R3pRapst3r/Trinity/CAD/Images/dragonUHF_toolhead_Front.png

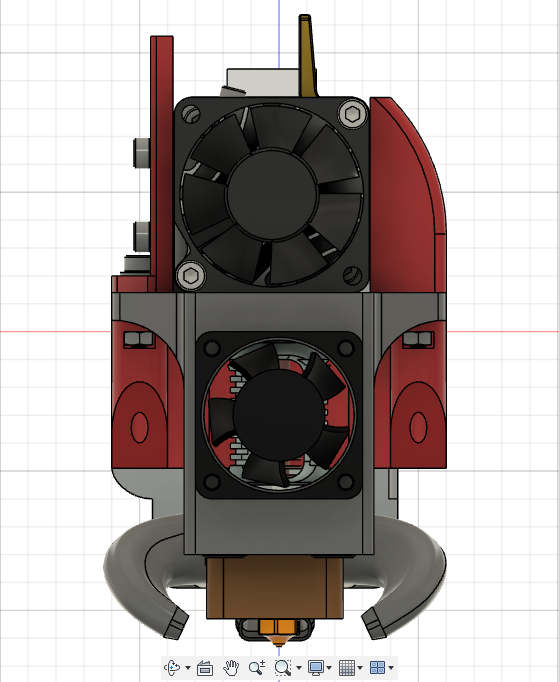
CAD/Images/dragonUHF_toolhead_Front.png
