R3pRapst3r/Trinity/CAD/Images/Front.png

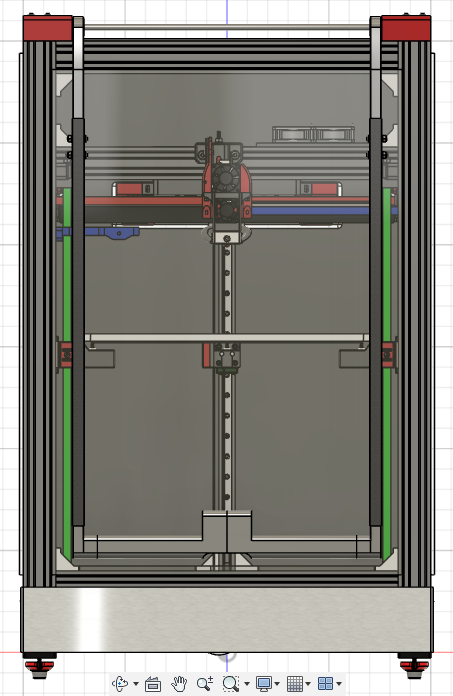
CAD/Images/Front.png
