R3pRapst3r/Trinity/CAD/Images/Rear.png

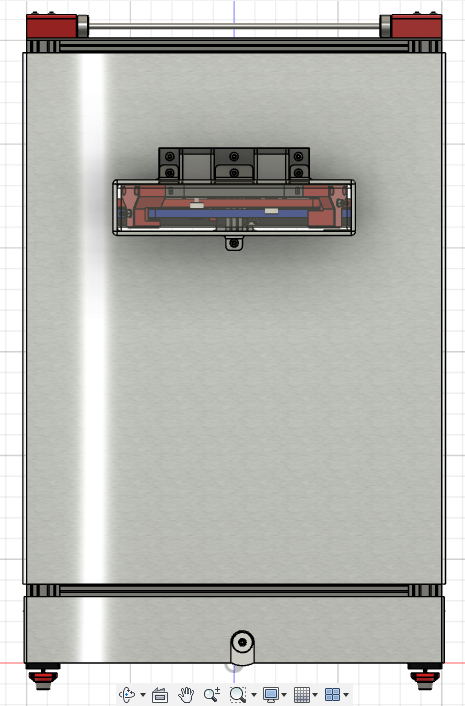
CAD/Images/Rear.png
