R3pRapst3r/Trinity/CAD/Images/Side.png

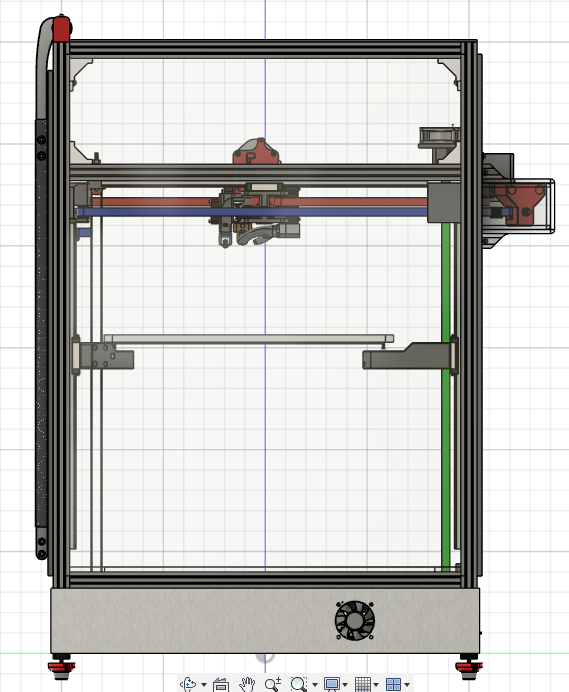
CAD/Images/Side.png
