R3pRapst3r/Trinity/Software/PrusaSlicer/customcode.png

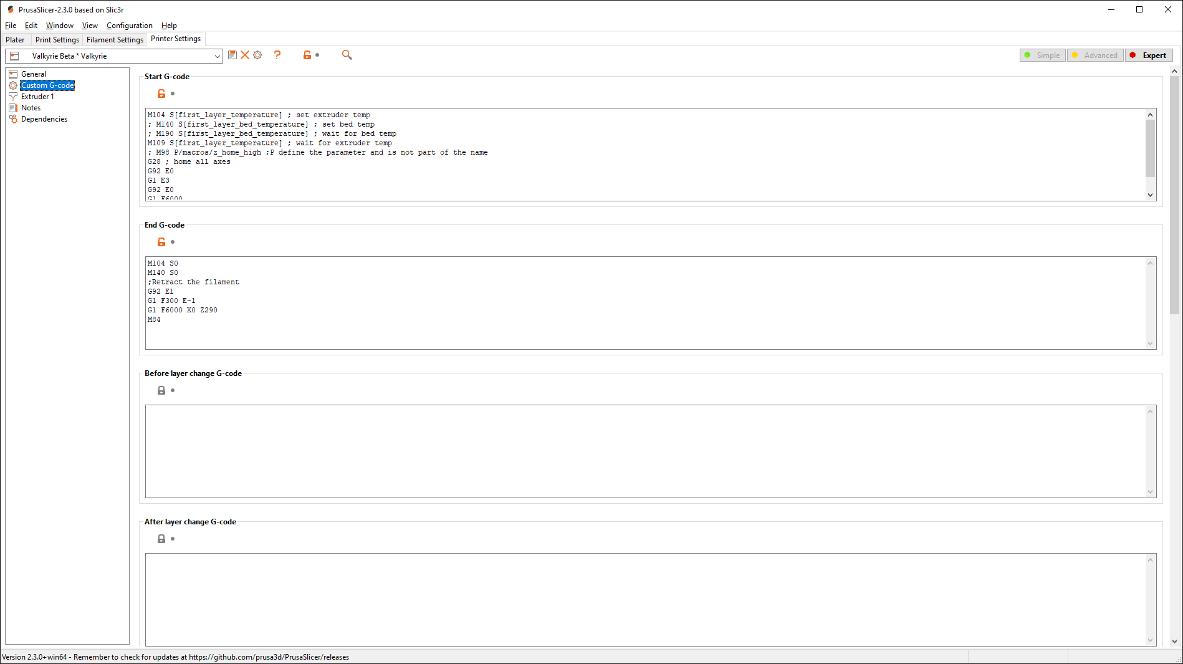
Software/PrusaSlicer/customcode.png
