R3pRapst3r/Trinity/Software/PrusaSlicer/extruder.png

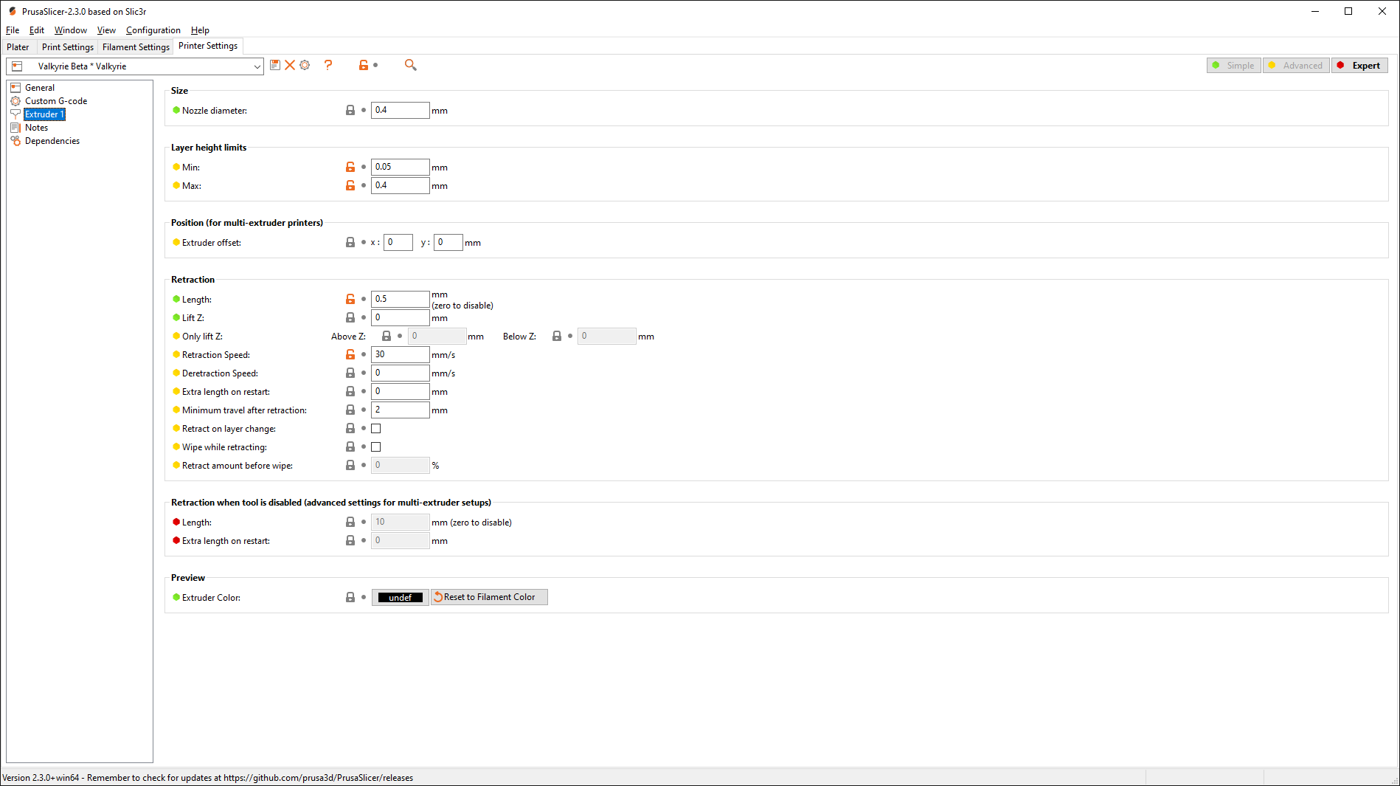
Software/PrusaSlicer/extruder.png
