R3pRapst3r/Trinity/Software/PrusaSlicer/general.png

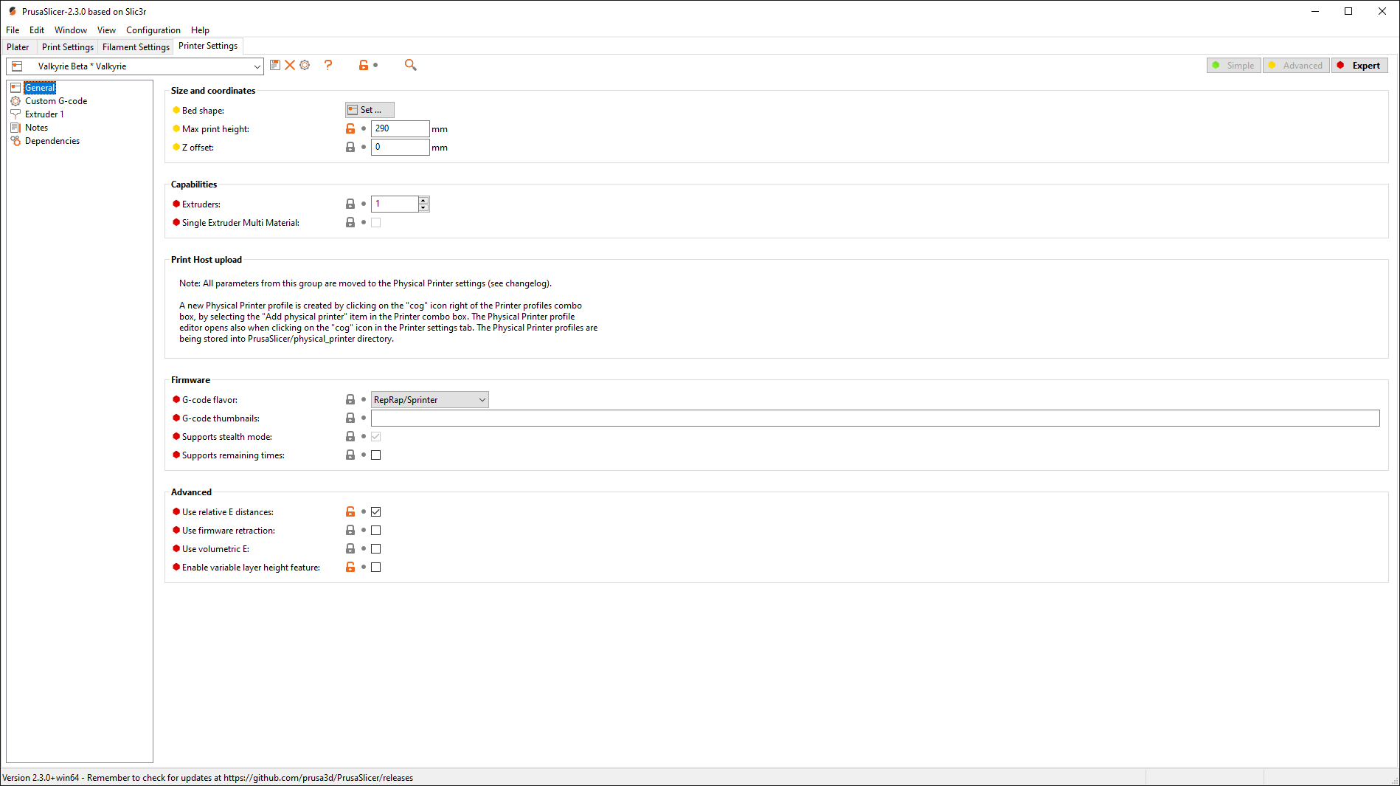
Software/PrusaSlicer/general.png
