R3pRapst3r/Trinity/BOM/BOM important notes.txt

BOM Note

IF ordering the CNA Hight temp full metal rails you MUST add a note in the order telling you want full metal carriages and medium preload!
