R3pRapst3r/Trinity/BOM/BOM v1.1.0.pdf

Valkyrie | 3d Printer Price exl VAT #REF!
System Category | Part Type Description Cut Length BOM Pack Price $ Pack Order Line Price $ mm Quantity Quantity | Order Parts Link Supplier
Frame Hardware Kinematic Motionparts Frame Hardware | T-Slot 2040 Z 2040 750 4 $ 14.70 4 $ 58.80 Linear Rails MGN 9h-Z Axis. NB! See note 400 1 $ 17.50 1 $ 17.50 Frame Bundle Frame Parts price exclusive Hardware #REF! | Color: 750 mm (https://s.click.aliexpress.com/e/_A2kG7t) 1xMGN9H/400mm Medium PL (https://s.click.aliexpress.com/e/_DdIajkF) | VenstPow CNA MS
Frame Hardware Frame Bundle Pick one of the kits below or order from above Frame Hardware Frame Bundle Misumi Frame & Rails & Hardware 1 $ 720.00 $ -Frame Hardware Frame Bundle V-Slot Frame & Rails & Hardware 1 $ 577.00 $ - | | Complete Premium Kit (https://makersupplies.dk/3d-print/3d-printers-kits/3d-printer-kits/valkyrie/3d-printers-kits-3d-printer-kits-valkyrie-frame-kit-misumi-t-slot) Complete V-Slot Kit (https://makersupplies.dk/3d-print/3d-printers-kits/3d-printer-kits/valkyrie/3d-printers-kits-3d-printer-kits-valkyrie-frame-kit-v-slot) | Partners MakerSupplies MakerSupplies
Frame | Hardware | T-Slot 2020 | Z 2020 Rear Center | 339 | 1 $ | 8.62 | 1 $ | 8.00 | Color: 339 mm (https://s.click.aliexpress.com/e/_9xANon) | VenstPow | Develompment Team Members
Frame | Hardware | T-Slot 2020 | X 2020 Rear Top | 420 | 1 $ | 9.50 | 1 $ | 9.50 | Color: 420 mm (https://s.click.aliexpress.com/e/_9xANon) | VenstPow | Mark Bridgewater - NZ
Frame | Hardware | T-Slot 2040 | X 2040 | 420 | 4 $ | 10.54 | 4 $ | 42.16 | Color: 420 mm (https://s.click.aliexpress.com/e/_A2kG7t) | VenstPow | Chris Lombardi - US
Frame | Hardware | T-Slot 2040 | Y 2040 | 480 | 4 $ | 11.12 | 4 $ | 44.48 | Color: 480 mm (https://s.click.aliexpress.com/e/_A2kG7t) | VenstPow | Roy Berntsen - NO
Frame | Hardware | Bracket | 2028 L Bracket | | 40 $ | 5.00 | 4 $ | 20.00 | 4x Color: 10pcs 2028 (https://s.click.aliexpress.com/e/_AqN7dv) | VenstPow | Support Links:
Frame | Hardware | Bracket | Corner Plate 90deg | | 4 $ | 10.00 | 4 $ | 40.00 | 1x 5pcs 2020 5 holes (https://s.click.aliexpress.com/e/_DdJj4Ej) | VenstPow | Buy Me a Coffee (https://ko-fi.com/pro3d)
Kinematic | Motionparts | Linear Rails | MGN 12h-Z Axis. NB! See note | 350 | 3 $ | 18.50 | 3 $ | 55.50 | 3xMGN 12H/350mm Medium PL (https://s.click.aliexpress.com/e/_DdIajkF) | CNA MS | By Patreon (https://www.patreon.com/pro3d)
Kinematic | Motionparts | Linear Rails | MGN 12h-Y Axis. NB! See note | 400 | 2 $ | 19.50 | 2 $ | 39.00 | 2xMGN12H/400mm Medium PL (https://s.click.aliexpress.com/e/_DdIajkF) | CNA MS | By PayPal (https://www.paypal.com/donate/?hosted_button_id=LZ7RAQGSE4SS8)
Frame | Hardware | Tube | 20x20x18 Carbon X-Axis Tube | 410 | 1 $ | 20.00 | 1 $ | 20.00 | 1x 20X20X18MM 500MM (https://s.click.aliexpress.com/e/_AK9Uei) | YTWS
Frame | Hardware | Tube | 15x15x13 Carbon Tube | 230 | 4 $ | 17.50 | 2 $ | 35.00 | 2x15X15X13MM 500MM (https://id.aliexpress.com/item/4000720317784.html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) | YTWS
Bed | Hardware | Plate | Cast Aluminum 350x350x8mm | 350 | 1225 $ | 0.08 | 1225 $ | 104.00 | 1225 cm^2 (https://makersupplies.dk/en/aluminum-sheet/921-aluminum-sheet-8mm-cnc-milled-cast-aluminum-sheet-custom-cut.html) | MakerSupplies
Bed | Hardware | Print Surface | Removal Spring Steel PEI Sheet | 330 | 1 $ | 46.00 | 1 $ | 46.00 | 1x Size: (130C)330x330mm (https://s.click.aliexpress.com/e/_9QsTsb) | Energetic
Bed | Hardware | Rod | 5x50mm Rod For Ball Joint | | 6 $ | 3.00 | 2 $ | 6.00 | 2x Length: 50mm 4PC (https://s.click.aliexpress.com/e/_AM7dI0) | WanFang
Bed | Hardware | Ball Joint | Precision Ball 10mm M4 | | 3 $ | 3.00 | 1 $ | 3.00 | 1x Size: 10pc (https://s.click.aliexpress.com/e/_ArYZR8) | KingRoon
AC/DC | Electronics | Controller Board | Duet 3 6HC | | 1 $ | 145.00 | 1 $ | 145.00 | 1x Duet 3 6HC (https://s.click.aliexpress.com/e/_DFJ8Ee7) | Fysetc
AC/DC | Electronics | PSU | Power Supply Unit | | 1 $ | 23.00 | 1 $ | 23.00 | 24V10A 240W (https://s.click.aliexpress.com/e/_9v6vDi) | Vusum
AC/DC | Electronics | Switch | Power Switch | | 1 $ | 7.50 | 1 $ | 7.50 | 1x Power switch (https://s.click.aliexpress.com/e/_AX4lXw) | TriangleLab
AC/DC | Electronics | Heater | Keenovo 750W Silicone Heater | 300 | 1 $ | 78.39 | 1 $ | 78.39 | 1x Color: 220V/110V (https://s.click.aliexpress.com/e/_AoRWc1) | Keenovo
AC/DC | Electronics | Switch | Solid State Relay | | 2 $ | 26.00 | 2 $ | 52.00 | Omron Solid State Relay (https://s.click.aliexpress.com/e/_DCq8m63) | Mellow
AC/DC | Electronics | Fuse | Thermal Fuse for AC Heater | | 1 $ | 3.00 | 1 $ | 3.00 | 1x Temperature: 150/180 degree (https://s.click.aliexpress.com/e/_AnVtSN) | Weidly
ToolHead | Electronics | Accelerometer | LIS3DSH Accelerometer | | 1 $ | 2.00 | 1 $ | 2.00 | 1x LIS3DSH Accelerometer (https://s.click.aliexpress.com/e/_APFI3d) | RQG
ToolHead | Extruder | Hotend | NF-Smart_Dg V2.0 | | 1 $ | 40.00 | 1 $ | 40.00 | 1x Color: Set 2/3/5/6 (https://s.click.aliexpress.com/e/_DlQsLtz) | Mellow
ToolHead | Extruder | Thermistor | PT1000 Thermistor Up to 450C | | 1 $ | 13.50 | 1 $ | 13.50 | 1x PT1000 Thermistor Cartridge (https://s.click.aliexpress.com/e/_9JVfyZ) | TriangleLab
ToolHead | Extruder | Extruder | BQ H2 V2S Lite | | 1 $ | 65.00 | 1 $ | 65.00 | H2 V2S LITE w/nema14 (https://s.click.aliexpress.com/e/_DFuG1tl) | BTT
ToolHead | Extruder | Tube | PTFE Teflon Tube | | 1 $ | 3.75 | 1 $ | 3.75 | 1x Size: 1M ID 2MM OD 3MM (https://s.click.aliexpress.com/e/_DnmpysP) | Mellow
ToolHead | Extruder | Tube | PTFE Teflon Tube | | 2 $ | 10.00 | 1 $ | 10.00 | 1x Size: 2M ID 4MM OD 6MM (https://s.click.aliexpress.com/e/_DnmpysP) | Mellow
Kinematic | Hardware | Rod | 5x25mm Rod For Tension Forks | | 5 $ | 1.20 | 1 $ | 1.20 | 1x Length: 25mm 8PC (https://s.click.aliexpress.com/e/_AM7dI0) | WanFang
Kinematic | Hardware | Rod | 5x40mm Rod For AB Idlers | | 12 $ | 3.00 | 3 $ | 9.00 | 3x Length: 40mm 5PC (https://s.click.aliexpress.com/e/_AM7dI0) | WanFang
Kinematic | Motionparts | Belt | Timing Belt 2GT 9mm 135C | | 8 $ | 59.00 | 1 $ | 59.00 | 1x 8M Heat Resistant - 9mm (https://s.click.aliexpress.com/e/_ABtzv6) | TriangleLab
Kinematic | Motionparts | Idler | Idlers Smooth 11mm | | 10 $ | 4.10 | 10 $ | 41.00 | 10x W 11mm without t (https://s.click.aliexpress.com/e/_9gG5gi) | Mellow
Kinematic | Motionparts | Idler | Idlers Toothed 11mm | | 5 $ | 6.00 | 5 $ | 30.00 | 5x W 11mm with t (https://s.click.aliexpress.com/e/_9gG5gi) | Mellow
Kinematic | Motionparts | Pulley | Pulley 11mm 2GT | | 5 $ | 4.00 | 5 $ | 20.00 | 5x For 9mm (https://s.click.aliexpress.com/e/_A6Q066) | Mellow
Kinematic | Motionparts | Gear | 2GT 20T-80T 4:1 Belt Gear | 200 | 3 $ | 16.00 | 3 $ | 48.00 | 3x 20T(5mm)-80T(5mm)-200mm (https://s.click.aliexpress.com/e/_9xvamN) | Powge
Kinematic | Motionparts | Steppermotor | 42mm NEMA 17 1.7A | | 5 $ | 14.50 | 5 $ | 72.50 | 1x 5Pcs 40mm 45N-cm 2A (https://s.click.aliexpress.com/e/_ALKIWP) | StepperOnline
Enclosure | Insulation | Insulation | PIR - Polyisocyanurate | | 5 $ | 12.00 | 5 $ | 60.00 | TBD (https://www.kingspan.com/gb/en-gb/products/insulation-boards/insulation-boards/therma) | Source Locally
Enclosure | Panel | Panels | Aluminum Composite Material | | 5 $ | 25.00 | 5 $ | 125.00 | TBD (https://www.curbellplastics.com/Research-Solutions/Materials/Aluminum-Composite-Material-(ACM)) | Source Locally
Enclosure | Panel | Window Front | Polycarbonate Sheet | 300 | 2 $ | 25.00 | 2 $ | 50.00 | Specification: 350x350x3mm (https://s.click.aliexpress.com/e/_ADhhGV) | BEAO
Enclosure | Electronics | Cable | High Temperature PTFE Cable | | 5 $ | 3.23 | 5 $ | 16.15 | 5x Length: 5 Meters (https://s.click.aliexpress.com/e/_DD5IYAj) | Antfox Store
Drybox | Electronics | Sensor | 5KG Load Cell and HX711 ADC | | 1 $ | 3.00 | 1 $ | 3.00 | Color: 5KG With HX711 (https://s.click.aliexpress.com/e/_9gb4OH) | Estardyn
Enclosure | Electronics | Fan | 60mm Sunon MF60202V3 | | 2 $ | 12.00 | 2 $ | 24.00 | 1x Sunon MF60202V3 (https://s.click.aliexpress.com/e/_Dlpy6BN) | SENSDA
Drybox | Electronics | Heater | PTC Heater 12x7cm 260C | | 1 $ | 12.00 | 1 $ | 12.00 | PTC Heater with Cord (US or EU) (https://www.aliexpress.com/item/1005003758412972.html) | YEKMLCO
Drybox | Electronics | Fuse | Thermal Fuse 95C | | 1 $ | 3.96 | 1 $ | 3.96 | 1x 15A - 95C (https://www.aliexpress.com/item/32885492280.html) | TS
Drybox | electronics | PCB assy | HX711 + 5kg Load cell | | 1 $ | 3.72 | 1 $ | 3.72 | 1x5kg loadcell + HX711 (https://s.click.aliexpress.com/e/_DlWkD9l) | EQV Store
Drybox | electronics | Controller Board | ESP32 WiFi Board | | 1 $ | 4.00 | 1 $ | 4.00 | 1xESP-32 30Pin (https://www.aliexpress.com/item/4000071762309.html) | EQV Store
Drybox | electronics | Controller Board | ESP32 DEV BOARD | | 1 $ | 3.00 | 1 $ | 3.00 | 1xESP32-V1 SHIELD 30P (https://www.aliexpress.com/item/4000071762309.html) | EQV Store
Drybox | electronics | Sensor | DHT22 Humididty + Temp Sensor | | 1 $ | 3.00 | 1 $ | 3.00 | 1xDHT22 Sensor (https://s.click.aliexpress.com/e/_DmMW6hH) | YX EC
Drybox | Drying Agent | Desiccant | Calsium Chloride | | 1 $ | 15.00 | 1 $ | 15.00 | Source Locally | Locally
Fasteners | Various See Fastener sheet 1 $226
Valkyrie | Bundle Price Price exl VAT #REF!

## valkyrie

## stage - I

## BOM
