R3pRapst3r/Trinity/BOM/Fasteners-BOM v1.1.0.pdf

Hardware Price exl VAT $ 226
Quantity Pack Price $ Pack Order BOM Line Price Part Type Description Quantity $ | Order Parts Link Supplier DIN ISO
Bushing | 5x8x2.5M Bushings | 2 $ | 4.31 | 1 $ | 4.31 | 1x 10pcs Bushings 5x8x2.5 (https://s.click.aliexpress.com/e/_9Gy22J) | GEPS | | | Develompment Team Members
Nut | M3 Nut | 44 $ | 1.00 | 1 $ | 1.00 | 1x Size: M3 50PCS (https://s.click.aliexpress.com/e/_AB2MMx) | WanFang | 934 | 4032 | Mark Bridgewater - NZ
Nut | M3 Nut Hammer Nut | 68 $ | 3.00 | 2 $ | 6.00 | 1x 50PCS Size: 20-m3 (https://s.click.aliexpress.com/e/_A3vamf) | WanFang | | | Chris Lombardi - US
Nut | M3 Nut Locknut | 6 $ | 0.49 | 1 $ | 0.49 | 1x Size: M3 50PCS - SS (https://s.click.aliexpress.com/e/_AKYhBV) | WanFang | | 10511 | Roy Berntsen - NO
Washer | M3 WASHER | 31 $ | 0.74 | 1 $ | 0.74 | 1x: M3 50pcs (https://id.aliexpress.com/item/1005003078979017.html) | WanFang | 125
M3-50 | M3x03 Set/Grub Screw | 8 $ | 0.56 | 1 $ | 0.56 | 1 x 50PCs M3 x 3 (https://s.click.aliexpress.com/e/_DmWF6r5) | WanFang | 916 | | Support Links:
Screw | M3x08 BH | 36 $ | 1.00 | 1 $ | 1.00 | 1x Size: M3 50PCS - 8mm - 304 SS (https://s.click.aliexpress.com/e/_A3cUtH) | WanFang | | 7380 | Buy Me a Coffee (https://ko-fi.com/pro3d)
Screw | M3x08 FH CS | 11 $ | 1.12 | 1 $ | 1.12 | 1 x 50PCs M3 x 8mm SS (https://www.aliexpress.com/item/32939396668.html) | WanFang | 7991 | 10642 | By Patreon (https://www.patreon.com/pro3d)
Screw | M3x08 SH | 38 $ | 1.00 | 1 $ | 1.00 | 1x Size: M3 50PCS - 8mm - 304 SS (https://s.click.aliexpress.com/e/_9JOB4f) | WanFang | 912 | | By PayPal (https://www.paypal.com/donate/?hosted_button_id=LZ7RAQGSE4SS8)
Screw | M3x10 BH | 31 $ | 1.00 | 1 $ | 1.00 | 1x Size: M3 50PCS - 10mm - 304 SS (https://s.click.aliexpress.com/e/_A2YDOx) | WanFang | | 7380
Screw | M3x10 SH | 29 $ | 1.07 | 1 $ | 1.07 | 1 x 50PCs M3 x 10mm SS (https://s.click.aliexpress.com/e/_Dmmm4hv) | WanFang | 912 | 4762
Screw | M3x16 BH | 11 $ | 2.00 | 1 $ | 2.00 | 1x Size: M3 50PCS - 16mm - 304 SS (https://s.click.aliexpress.com/e/_A2YDOx) | WanFang | | 7380
Screw | M3x25 SH | 4 $ | 1.50 | 1 $ | 1.50 | 1 x 50 Pcs M3 x 25 SS (https://s.click.aliexpress.com/e/_DkbO2A7) | WanFang | 912
Spacer | M3x30 FF Standoff | 4 $ | 3.27 | 1 $ | 3.27 | 1x Size: M3 - 30mm (https://s.click.aliexpress.com/e/_AfiKZd) | WanFang
Spacer | M3x30 FM Standoff | 4 $ | 2.57 | 1 $ | 2.57 | 1x Size: 5PCS M3XL M-F (https://s.click.aliexpress.com/e/_9yFDij) | WanFang
Screw | M4 D5 L55 Shoulder Screw | 3 $ | 4.00 | 3 $ 12.00 | 3x Size: M4-D5mm x 55mm (https://s.click.aliexpress.com/e/_9x0mWr) | YFS

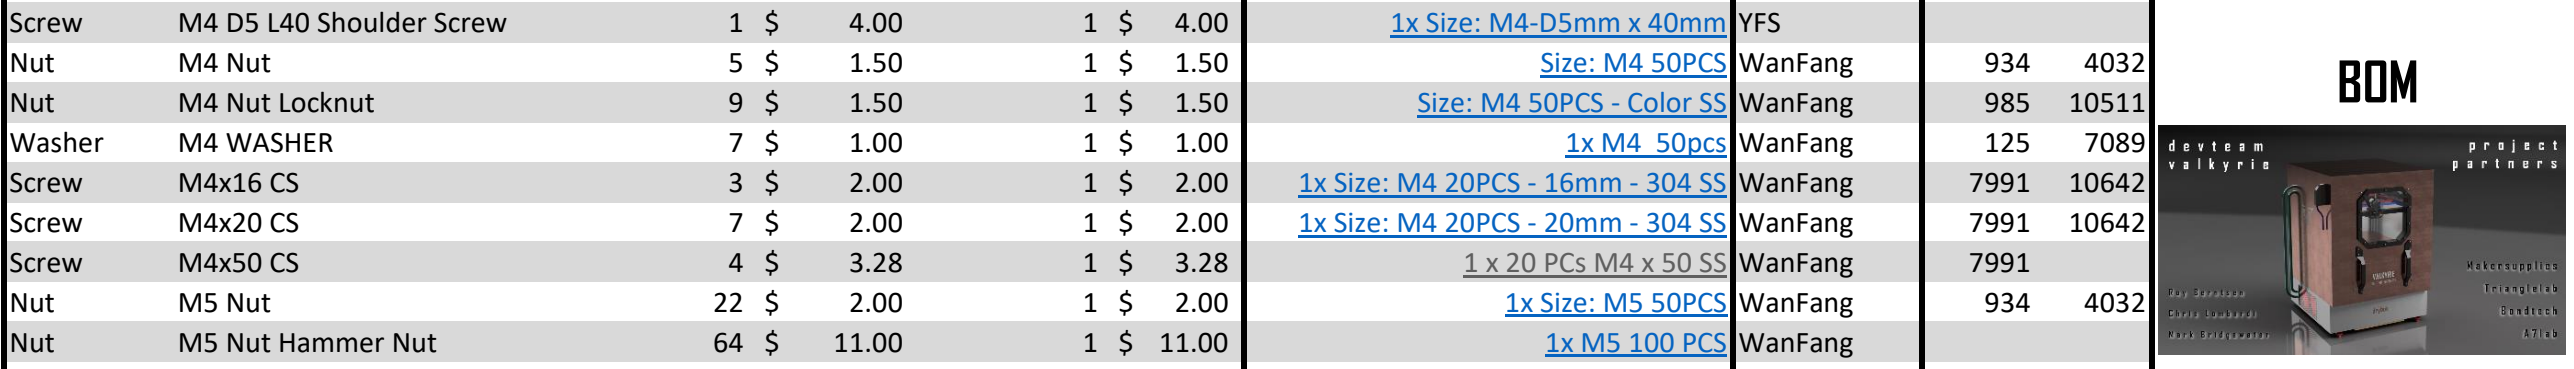
[picture p10: figure]
Screw; M4 D5 L40 Shoulder Screw; 1x Size: M4-D5mm x 40mm; YFS; Nut; M4 Nut; Size: M4 50PCS; WanFang; Washer; M4 WASHER; 1x M4 50pcs; M5 Nut; 1x Size: M5 50PCS; M5 Nut Hammer Nut; 1x M5 100 PCS; BOM

Nut | M4 Nut Locknut | 9 $ | 1.50 | 1 $ | 1.50 | Size: M4 50PCS - Color SS (https://s.click.aliexpress.com/e/_AkJ18P) | WanFang | 985 | 10511
Screw | M4x16 CS | 3 $ | 2.00 | 1 $ | 2.00 | 1x Size: M4 20PCS - 16mm - 304 SS (https://s.click.aliexpress.com/e/_9RUjsB) | WanFang | 7991 | 10642
Screw | M4x20 CS | 7 $ | 2.00 | 1 $ | 2.00 | 1x Size: M4 20PCS - 20mm - 304 SS (https://s.click.aliexpress.com/e/_ASPnXl) | WanFang | 7991 | 10642
Screw | M4x50 CS | 4 $ | 3.28 | 1 $ | 3.28 | 1 x 20 PCs M4 x 50 SS (https://s.click.aliexpress.com/e/_DCNVYyb) | WanFang | 7991
Nut | M5 Nut Locknut | 15 $ | 2.81 | 1 $ | 2.81 | 1x M5 50 PCS - SS (https://s.click.aliexpress.com/e/_ACjUAP) | WanFang | 985 | 10511
Nut | M5 Nut T-Nut | 72 $ | 13.50 | 1 $ 13.50 | 1x M5 100PCS (https://s.click.aliexpress.com/e/_9iXP6T) | WanFang
Collar | M5 Retaining Collar | 1 $ | 3.62 | 1 $ | 3.62 | GDZS-D5-10-6 (https://s.click.aliexpress.com/e/_Aoo551) | Micky
Washer | M5 WASHER | 141 $ | 1.28 | 2 $ | 2.56 | 2x M5 50PCS (https://s.click.aliexpress.com/e/_9vb6PD) | WanFang | 125 | 7089
Screw | M5x10 BH | 141 $ | 2.69 | 15 $ 40.35 | 12x 10PCS Size: M5 - 10mm - SS (https://s.click.aliexpress.com/e/_AkraqJ) | WanFang | 7380
Screw | M5x20 BH | 9 $ | 8.00 | 1 $ | 8.00 | 1x 10PCS Size: M5 - 20mm - SS (https://s.click.aliexpress.com/e/_9zqQrh) | WanFang | | 7380
Screw | M5x30 BH | 4 $ | 1.64 | 1 $ | 1.64 | 1 x 5PCS M5 x 30 ss (https://s.click.aliexpress.com/e/_DesnUZp) | YFS | | 7380
Bolt | M5x30 HEX | 5 $ | 2.57 | 1 $ | 2.57 | 1x 10 PCS Size: M5 - 30mm (https://s.click.aliexpress.com/e/_980mef) | WanFang | 933
Bolt | M5x50 HEX DIN 933 | 15 $ | 3.04 | 2 $ | 6.08 | 1 x 10 PCs M5 x 50 (https://www.aliexpress.com/item/1005003034350931.html) | WanFang | 933
Shim | M5x6.5x1 Precision Shim | 33 $ | 16.00 | 1 $ 16.00 | 1x 200PCS Size: 6.5x5x1mm (https://s.click.aliexpress.com/e/_DFr9KHh) | BulkMan
Rod | M8x380 Steel Rod - Door Link | 1 $ | 9.50 | 1 $ | 9.50 | 1 x 8mm dia x 400mm SS (https://s.click.aliexpress.com/e/_Dmf08Nh) | YUNSHUO
Magnet | Round Magnets With Hole | 3 $ | 4.50 | 1 $ | 4.50 | 1x Color: 8x3-3mm-20pcs (https://s.click.aliexpress.com/e/_9H0d0B) | HongKai
Magnet | Ø20 10Kg Magnet + washer | 6 $ | 9.20 5 +1 | $ | 9.20 | 5 + 1 D20 magnet and keeper (https://s.click.aliexpress.com/e/_DloVAMP) | LFYGY Ind (https://www.aliexpress.com/store/912301249)
Bearings | 625 2ZZ | 6 $ | 7.50 | 1 $ | 7.50 | 10pcs 625ZZ 5x16x5mm (https://s.click.aliexpress.com/e/_AZ42Hh) | VenstPow
Bearings | Draw Slides | 2 $ | 24.00 | 1 $ 24.00 | Color: Buffer 16inch 40cm (https://s.click.aliexpress.com/e/_9gB9LL) | Naierdi
Bearings | 608 Bearings | 3 $ | 5.01 | 1 $ | 5.01 | 1x Size: ABEC-1 ZZ (https://s.click.aliexpress.com/e/_AbdgsT) | Kande
Spring | Tension Spring | 1 $ | 1.72 | 1 $ | 1.72 | 1x Length 15mm - Wire 0.7 - OD 8 (https://s.click.aliexpress.com/e/_AN8H8f) | Zhongfa
Fasteners Price exl VAT | $ | 226

# Project Valkyrie Fastener BOM

# valkyrie

# fasteners
