R3pRapst3r/Trinity/STLs/Printed parts list.xlsx

Sheet: Sheet1
Valkyrie | Frame Parts | Total time / weight |  |  | 111:10:00 | 3217 g
Price/kg | $40.00 | add your price
Price/g | $0.04 |  |  |  |  | $128.68
System | Part | Time | Weight | Quantity | Time Tot | Weight Tot | Support
AB | A Idler Bracket Front_1x | 0:37:00 | 22 g | 1 | 0:37:00 | 22 | No
AB | A Idler Bracket Rear_1x | 1:03:00 | 40 g | 1 | 1:03:00 | 40 | No
AB | A Idler Tension Tower_1x | 1:09:00 | 39 g | 1 | 1:09:00 | 39 | No
AB | A Y-Carrier A1_1x | 0:28:00 | 14 g | 1 | 0:28:00 | 14 | No
AB | A Y-Carrier A2_1x | 0:53:00 | 28 g | 1 | 0:53:00 | 28 | No
AB | AB Motor Bracket_1x | 4:46:00 | 185 g | 1 | 4:46:00 | 185 | No
AB | AB Toolhead Carrier_1x | 0:00:00 | 31 g | 1 | 0:00:00 | 31 | BPO
AB | AB Toolhead Fan Chimney_1x | 0:33:00 | 14 g | 1 | 0:33:00 | 14 | No
AB | AB Toolhead Fan Duct_1x | 0:20:00 | 14 g | 1 | 0:20:00 | 14 | No
AB | AB Toolhead Top Plate_1x | 0:42:00 | 10 g | 1 | 0:42:00 | 10 | No
AB | B Idler Bracket Front_1x | 0:35:00 | 22 g | 1 | 0:35:00 | 22 | No
AB | B Idler Bracket Rear_1x | 1:03:00 | 40 g | 1 | 1:03:00 | 40 | No
AB | B Idler Tension Tower_1x | 1:13:00 | 40 g | 1 | 1:13:00 | 40 | No
AB | B Y-Carrier B1_1x | 0:28:00 | 14 g | 1 | 0:28:00 | 14 | No
AB | B Y-Carrier B2_1x | 0:52:00 | 28 g | 1 | 0:52:00 | 28 | No
Z | Z AB-Belt Lock_2x | 0:13:00 | 6 g | 2 | 0:26:00 | 12 | No
Z | Z ABC Tension Fork_3x | 0:08:00 | 4 g | 3 | 0:24:00 | 12 | No
Z | Z AB-Coverbuddy_2x | 0:11:00 | 8 g | 2 | 0:22:00 | 16 | No
Z | Z A-Carrier_1x | 1:40:00 | 61 g | 1 | 1:40:00 | 61 | No
Z | Z A-Gear Bracket_1x | 1:23:00 | 56 g | 1 | 1:23:00 | 56 | No
Z | Z A-Gear Cover_1x | 1:48:00 | 68 g | 1 | 1:48:00 | 68 | No
Z | Z B-Carrier_1x | 1:40:00 | 61 g | 1 | 1:40:00 | 61 | No
Z | Z B-Gear Bracket_1x | 1:22:00 | 56 g | 1 | 1:22:00 | 56 | No
Z | Z B-Gear Cover_1x | 1:47:00 | 68 g | 1 | 1:47:00 | 68 | No
Z | Z C-Belt Lock_1x | 0:14:00 | 6 g | 1 | 0:14:00 | 6 | No
Z | Z C-Carrier_1x | 1:54:00 | 71 g | 1 | 1:54:00 | 71 | No
Z | Z C-Gear Bracket_1x | 1:33:00 | 63 g | 1 | 1:33:00 | 63 | No
Z | Z C-Coverbuddy_1x | 0:08:00 | 6 g | 1 | 0:08:00 | 6 | No
Z | Z C-Gear Cover_1x | 1:52:00 | 68 g | 1 | 1:52:00 | 68 | No
Z | Z Idler Bracket AB_2x | 0:42:00 | 24 g | 2 | 1:24:00 | 48 | No
Z | Z Idler Bracket C_1x | 0:58:00 | 34 g | 1 | 0:58:00 | 34 | No
Chamber | Door Handle A_1x | 1:08:00 | 46 g | 1 | 1:08:00 | 46 | No
Chamber | Door Handle B_1x | 1:08:00 | 46 g | 1 | 1:08:00 | 46 | No
Chamber | Door Magnet Buddy Lower AB_2x | 0:17:00 | 10 g | 2 | 0:34:00 | 20 | No
Chamber | Door Window Frame Inner_2x | 2:53:00 | 123 g | 2 | 5:46:00 | 246 | No
Chamber | Door Window Frame Outer_1x | 2:30:00 | 107 g | 1 | 2:30:00 | 107 | No
Chamber | Doorlift Door Bracket A_1x | 2:00:00 | 80 g | 1 | 2:00:00 | 80 | No
Chamber | Doorlift Door Bracket B_1x | 2:00:00 | 80 g | 1 | 2:00:00 | 80 | No
Chamber | Doorlift Lower Arm Bracket AB_2x | 0:16:00 | 9 g | 2 | 0:32:00 | 18 | No
Chamber | Doorlift Upper Arm Bracket A_1x | 0:45:00 | 27 g | 1 | 0:45:00 | 27 | No
Chamber | Doorlift Upper Arm Bracket B_1x | 0:45:00 | 27 g | 1 | 0:45:00 | 27 | No
Chamber | LUA - Lower Elbow_4x | 0:19:00 | 11 g | 4 | 1:16:00 | 44 | BPO
Chamber | LA-AB Upper Elbow_2x | 0:22:00 | 12 g | 2 | 0:44:00 | 24 | BPO
Chamber | Rear AB Motor Cover_1x | 10:00:00 | 400 g | 1 | 10:00:00 | 400 | No
Chamber | UA-A Upper Elbow_1x | 0:33:00 | 19 g | 1 | 0:33:00 | 19 | BPO
Chamber | UA-B Upper Elbow_1x | 0:33:00 | 19 g | 1 | 0:33:00 | 19 | BPO
Drybox | dbx drawslide buddy spacer_4x | 0:09:00 | 5 g | 4 | 0:36:00 | 20 | No
Drybox | dbx drawslide buddy_4x | 0:09:00 | 5 g | 4 | 0:36:00 | 20 | No
Drybox | dbx fanduct stand_2x | 0:22:00 | 12 g | 2 | 0:44:00 | 24 | No
Drybox | dbx fanduct_1x | 4:00:00 | 175 g | 1 | 4:00:00 | 175 | No
Drybox | dbx silica container lid_2x | 0:20:00 | 14 g | 2 | 0:40:00 | 28 | No
Drybox | dbx silica container_2x | 4:45:00 | 111 g | 2 | 9:30:00 | 222 | No
Drybox | Carousel Bearing Pin_3x | 0:04:00 | 2 g | 3 | 0:12:00 | 6 | No
Drybox | Carousel Bottom Bearing Plate_1x | 2:03:00 | 84 g | 1 | 2:03:00 | 84 | No
Drybox | Carousel Inner Lower Ring_1x | 0:48:00 | 33 g | 1 | 0:48:00 | 33 | No
Drybox | Carousel Inner Upper Ring_1x | 0:40:00 | 26 g | 1 | 0:40:00 | 26 | No
Drybox | Carousel Loadcell Spacer_1x | 0:08:00 | 3 g | 1 | 0:08:00 | 3 | No
Drybox | Carousel Outer Ring_1x | 2:35:00 | 104 g | 1 | 2:35:00 | 104 | No
Drybox | Carousel Spool Jaw_3x | 0:05:00 | 2 g | 3 | 0:15:00 | 6 | No
Drybox | Carousel Spring Cup_1x | 0:02:00 | 1 g | 1 | 0:02:00 | 1 | No
Drybox | Carousel Tightner Tool_1x | 0:30:00 | 15 g | 1 | 0:30:00 | 15 | No
Frame Parts | Total time / weight |  |  |  | 111:10:00 | 3217 g
Estimated filament price
Price/kg | $40.00
Price/g | $0.04 |  |  |  |  | $128.68

Sheet: Sheet2
System | Part | Time | Weight | Quantity | Time Tot | Weight Tot | Support
Chamber | Door Handle A_1x | 1:08:00 |  | 1 | 1:08:00 |  | No
Chamber | Door Handle B_1x | 1:08:00 |  | 1 | 1:08:00 |  | No
Chamber | Door Magnet Buddy Lower AB_2x | 0:17:00 |  | 2 | 0:34:00 |  | No
Chamber | Door Window Frame Inner_2x | 2:53:00 |  | 2 | 5:46:00 |  | No
Chamber | Door Window Frame Outer_1x | 2:30:00 |  | 1 | 2:30:00 |  | No
Chamber | Doorlift Lower Arm Bracket AB_2x | 0:16:00 |  | 2 | 0:32:00 |  | No
Chamber | Doorlift Upper Arm Bracket A_1x | 0:45:00 |  | 1 | 0:45:00 |  | No
Chamber | Doorlift Upper Arm Bracket B_1x | 0:45:00 |  | 1 | 0:45:00 |  | No
Chamber | LA-A Lower Elbow_1x | 0:19:00 |  | 1 | 0:19:00 |  | No
Chamber | LA-A Upper Elbow_1x | 0:22:00 |  | 1 | 0:22:00 |  | No
Chamber | LA-B Lower Elbow_1x | 0:19:00 |  | 1 | 0:19:00 |  | No
Chamber | LA-B Upper Elbow_1x | 0:22:00 |  | 1 | 0:22:00 |  | No
Chamber | Rear AB Motor Cover_1x | 10:00:00 |  | 1 | 10:00:00 |  | No
Chamber | UA-A Lower Elbow_1x | 0:19:00 |  | 1 | 0:19:00 |  | No
Chamber | UA-A Upper Elbow_1x | 0:33:00 |  | 1 | 0:33:00 |  | No
Chamber | UA-B Lower Elbow_1x | 0:19:00 |  | 1 | 0:19:00 |  | No
Chamber | UA-B Upper Elbow_1x | 0:33:00 |  | 1 | 0:33:00 |  | No
