R3pRapst3r/Trinity/CAD/355mm_build_plate.step

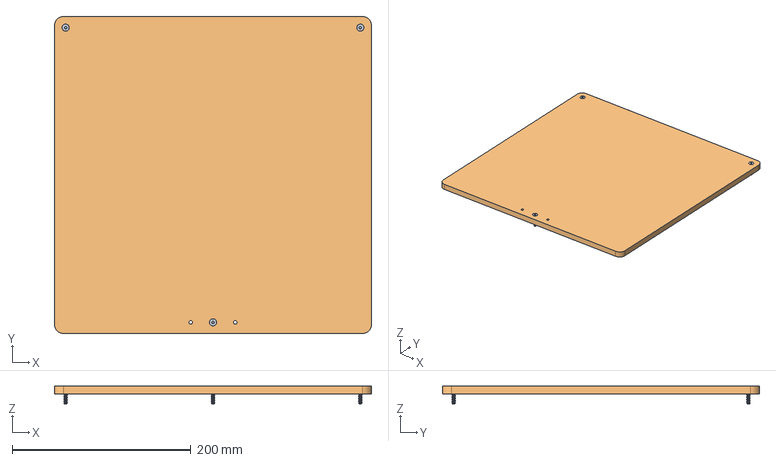
[picture p11: CAD file, 2024-07-05]
CAD/355mm_build_plate.step
355.0 x 355.0 x 20.0 mm
92125A198_18-8 Stainless Steel Hex Drive Flat Head Screw x 3
