R3pRapst3r/Trinity/Software/PrusaSlicer/Prusa Valkyrie Skins/prusa 350 x 350 valkyrie build plate_v2.stl

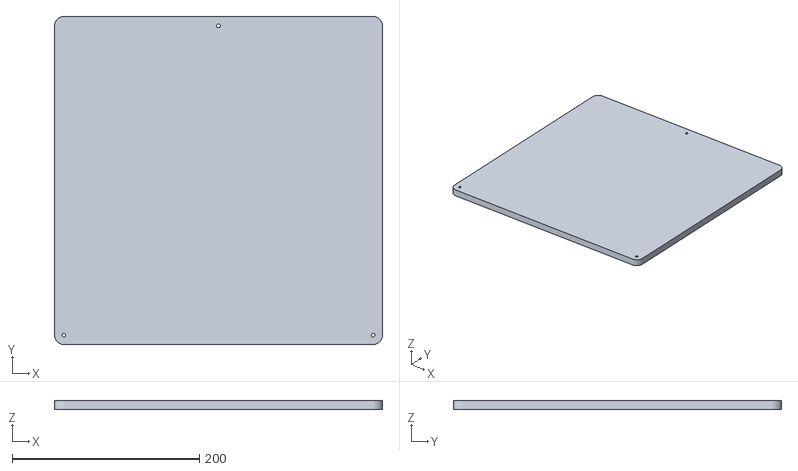
[picture p12: CAD file, 2024-06-25]
Software/PrusaSlicer/Prusa Valkyrie Skins/prusa 350 x 350 valkyrie build plate_v2.stl
350.0 x 350.0 x 10.0
