R3pRapst3r/Trinity/STLs/AB System/A Idler Tension Tower_1x.stl

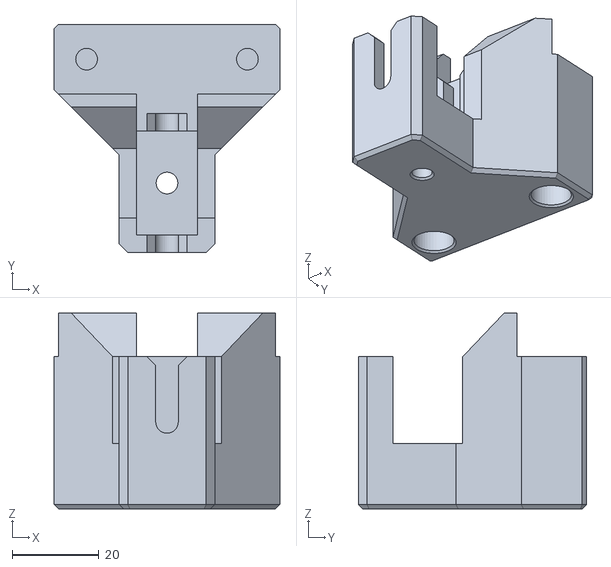
[picture p13: CAD file, 2024-06-25]
STLs/AB System/A Idler Tension Tower_1x.stl
52.0 x 52.5 x 45.0
