R3pRapst3r/Trinity/STLs/Enclosure/DIN_Rail_Mount_4x.stl

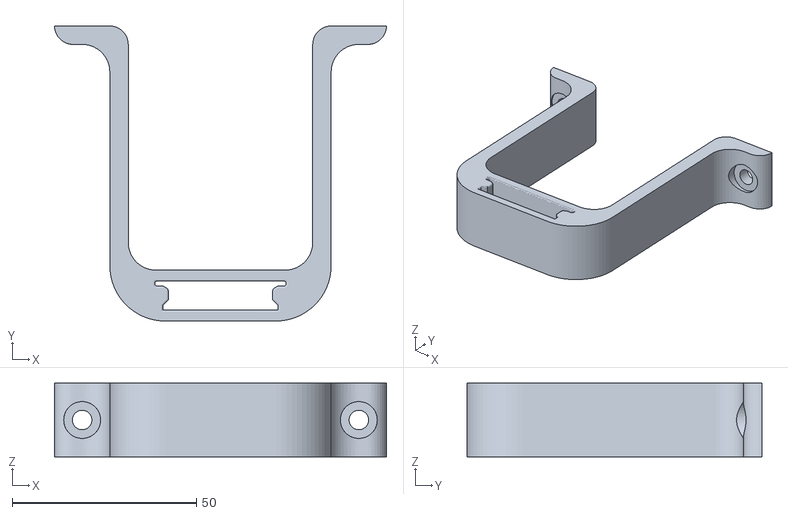
[picture p14: CAD file, 2024-07-25]
STLs/Enclosure/DIN_Rail_Mount_4x.stl
90.0 x 80.0 x 20.0
