R3pRapst3r/Trinity/STLs/Frame Leg Base_4x.stl

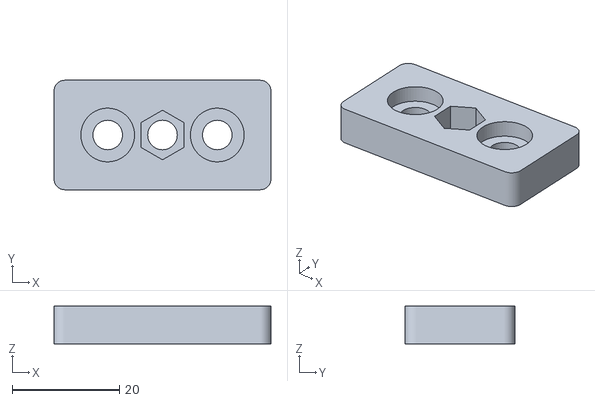
[picture p15: CAD file, 2024-06-25]
STLs/Frame Leg Base_4x.stl
40.4 x 20.4 x 7.00
