R3pRapst3r/Trinity/STLs/Toolhead/Toolhead_ExtruderEBB_Mount.stl

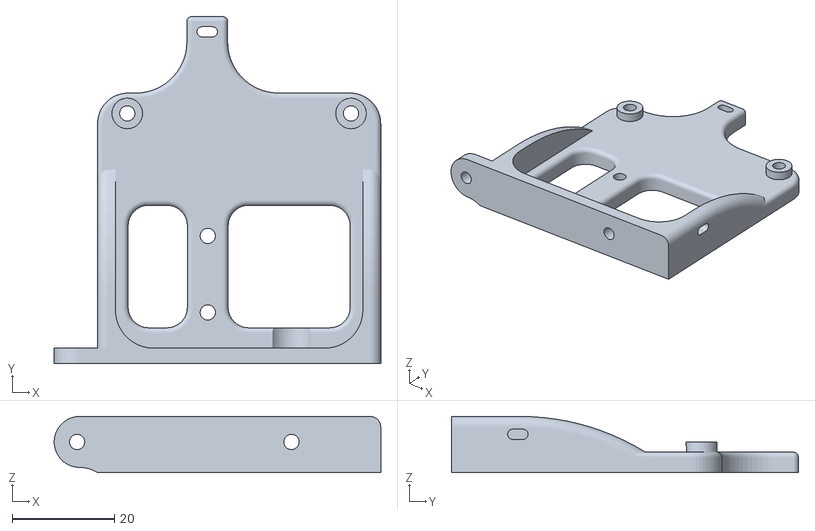
[picture p16: CAD file, 2024-07-05]
STLs/Toolhead/Toolhead_ExtruderEBB_Mount.stl
64.0 x 68.0 x 11.0
