R3pRapst3r/Trinity/STLs/Z System/Z C-Gear Cover_1x.stl

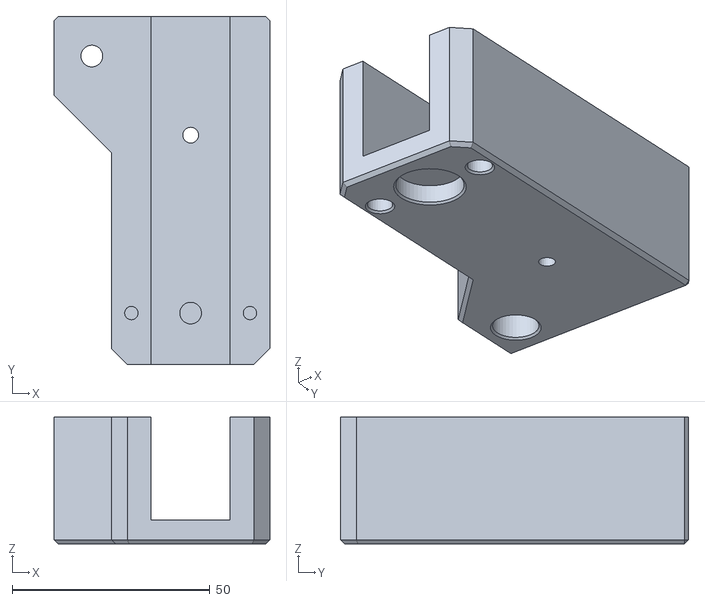
[picture p17: CAD file, 2024-06-25]
STLs/Z System/Z C-Gear Cover_1x.stl
54.5 x 88.0 x 32.0
