R3pRapst3r/Trinity/CAD/PTC Heater Mount.step

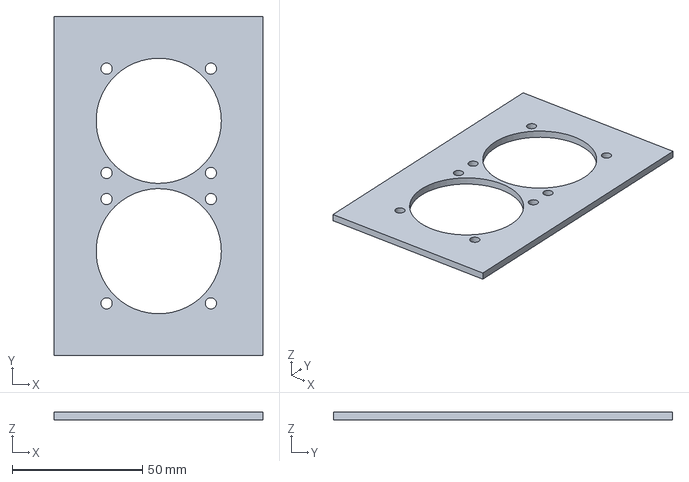
[picture p18: CAD file, 2024-06-29]
CAD/PTC Heater Mount.step
80.0 x 130.0 x 3.00 mm
