R3pRapst3r/Trinity/STLs/AB System/A Idler Bracket Front_1x.stl

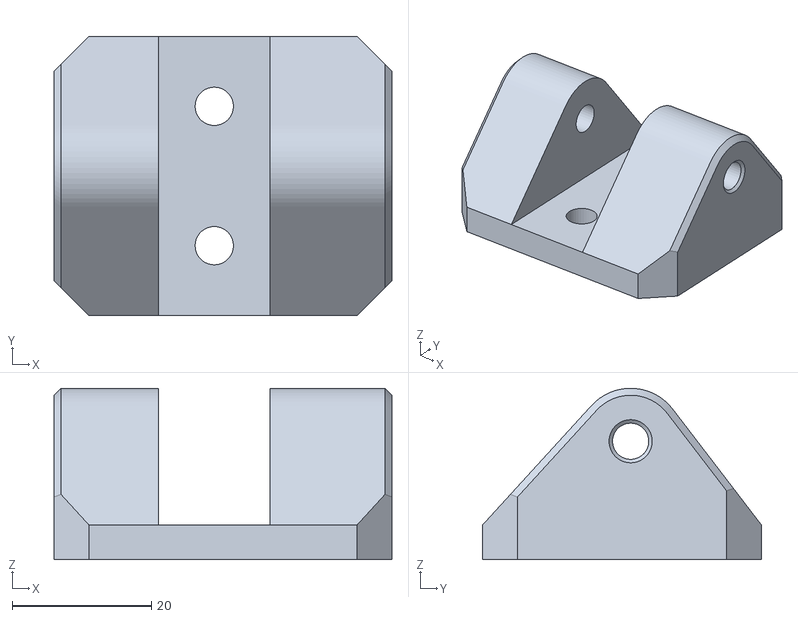
[picture p19: CAD file, 2024-06-25]
STLs/AB System/A Idler Bracket Front_1x.stl
48.5 x 40.0 x 24.6
