R3pRapst3r/Trinity/STLs/Enclosure/UA-A Upper Elbow_1x.stl

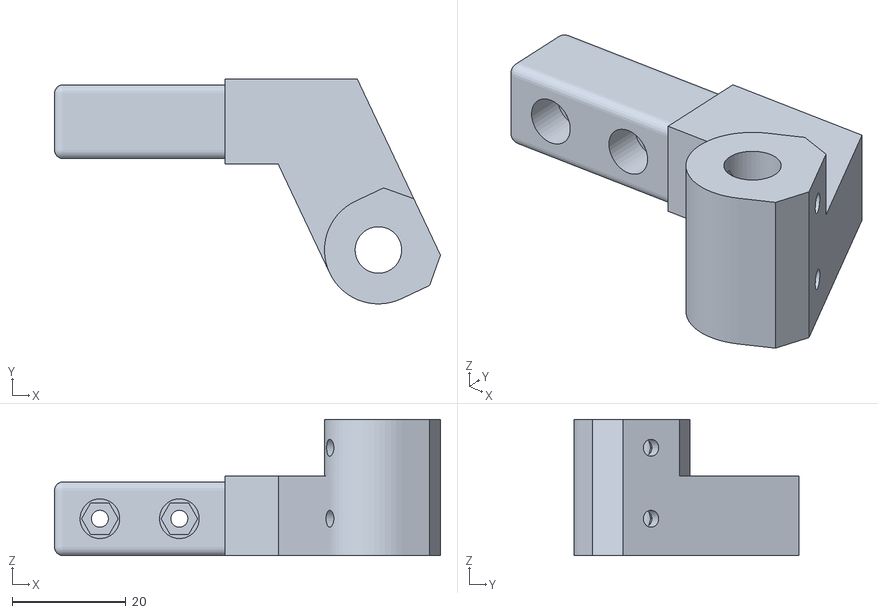
[picture p20: CAD file, 2024-06-25]
STLs/Enclosure/UA-A Upper Elbow_1x.stl
68.0 x 39.6 x 24.0
