R3pRapst3r/Trinity/STLs/Toolhead/Toolhead_Carrier.stl

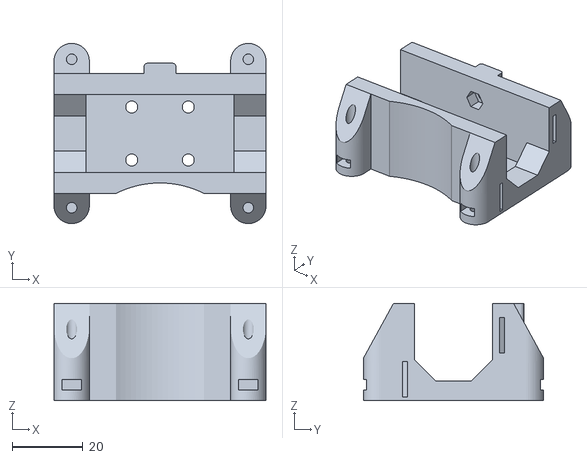
[picture p21: CAD file, 2024-07-05]
STLs/Toolhead/Toolhead_Carrier.stl
60.0 x 51.0 x 27.5
