R3pRapst3r/Trinity/STLs/Z System/Z A-Gear Bracket_1x.stl

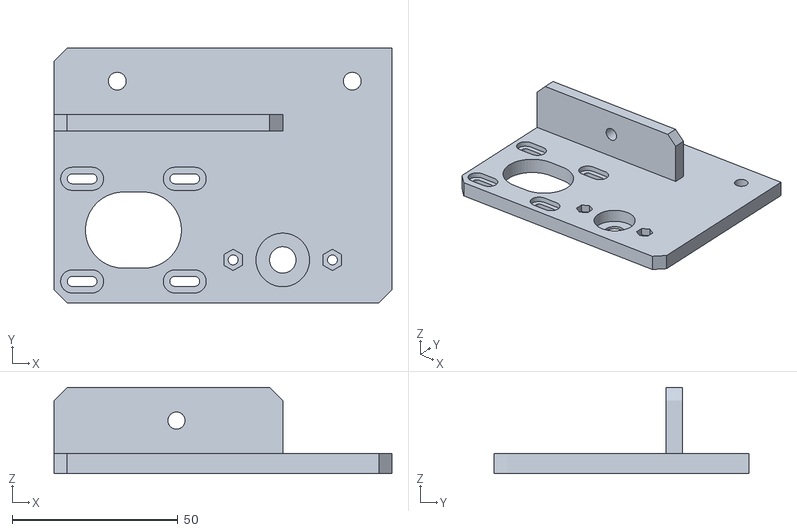
[picture p22: CAD file, 2024-06-25]
STLs/Z System/Z A-Gear Bracket_1x.stl
102.1 x 77.0 x 26.0
