R3pRapst3r/Trinity/CAD/350mm_build_plate.dxf

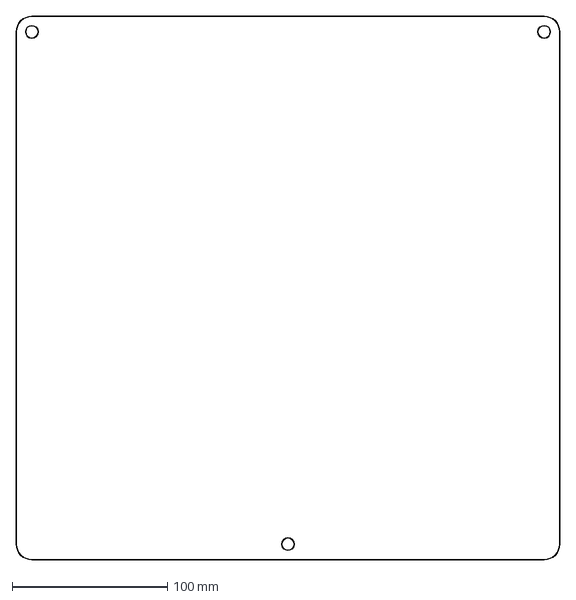
[picture p23: CAD file, 2024-06-25]
CAD/350mm_build_plate.dxf
350.0 x 350.0 mm
