R3pRapst3r/Trinity/STLs/Enclosure/Door Magnet Buddy Lower AB_2x.stl

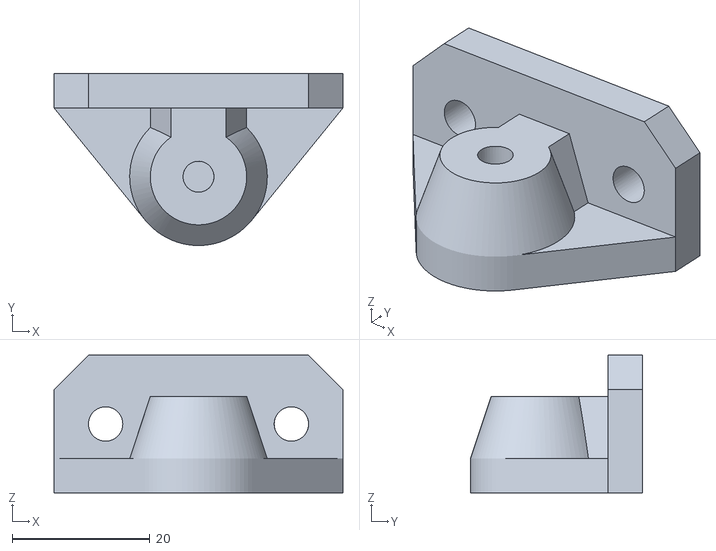
[picture p24: CAD file, 2024-06-25]
STLs/Enclosure/Door Magnet Buddy Lower AB_2x.stl
42.0 x 25.0 x 20.0
