R3pRapst3r/Trinity/STLs/Toolhead/Toolhead_Duct_Spacer.stl

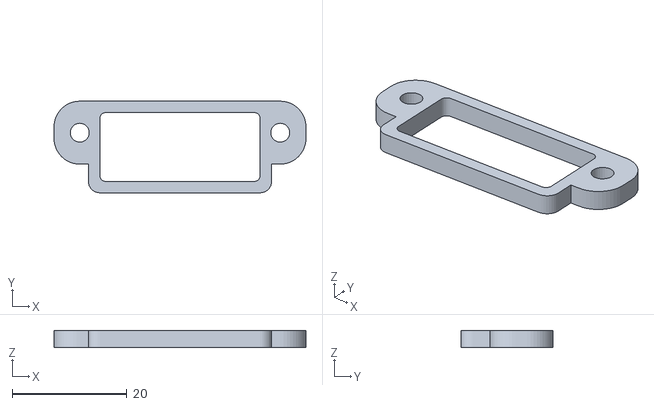
[picture p25: CAD file, 2024-07-03]
STLs/Toolhead/Toolhead_Duct_Spacer.stl
44.0 x 16.0 x 3.00
