R3pRapst3r/Trinity/STLs/Z System/Z B-Gear Cover_1x.stl

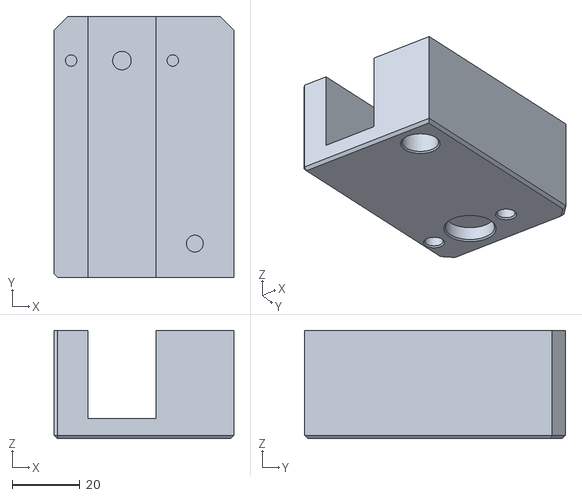
[picture p26: CAD file, 2024-06-25]
STLs/Z System/Z B-Gear Cover_1x.stl
53.0 x 77.0 x 32.0
