R3pRapst3r/Trinity/CAD/Enclosure_bottom_plate.dxf

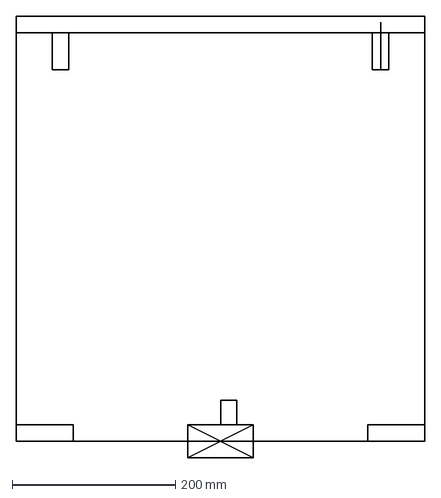
[picture p27: CAD file, 2024-06-25]
CAD/Enclosure_bottom_plate.dxf
500.0 x 540.0 mm
