R3pRapst3r/Trinity/STLs/AB System/B Idler Bracket Rear_1x.stl

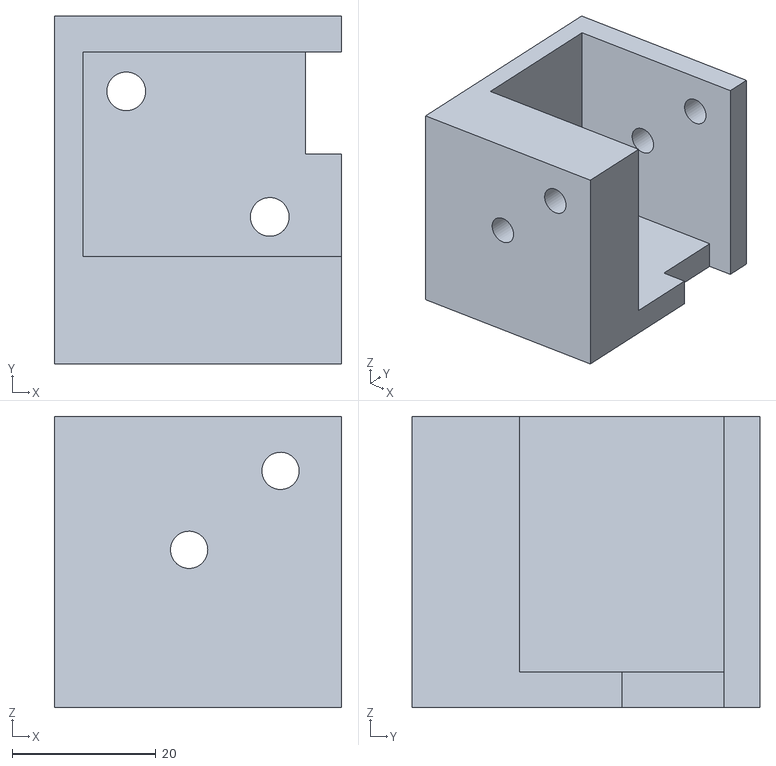
[picture p28: CAD file, 2024-06-25]
STLs/AB System/B Idler Bracket Rear_1x.stl
40.0 x 48.5 x 40.6
