R3pRapst3r/Trinity/STLs/Enclosure/Doorlift Door Bracket B_1x.stl

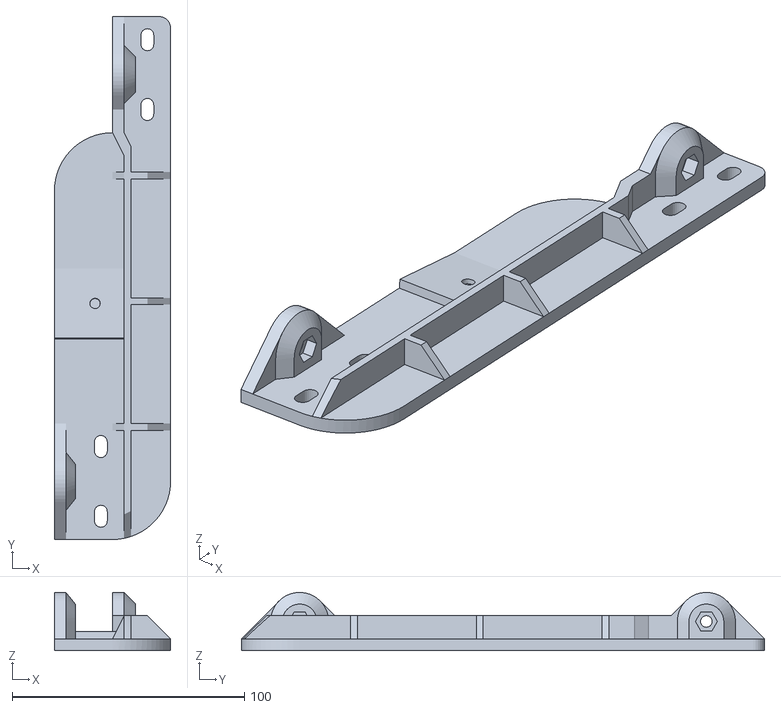
[picture p29: CAD file, 2024-06-25]
STLs/Enclosure/Doorlift Door Bracket B_1x.stl
50.0 x 225.0 x 25.0
