R3pRapst3r/Trinity/STLs/Toolhead/Toolhead_5015_Duct.stl

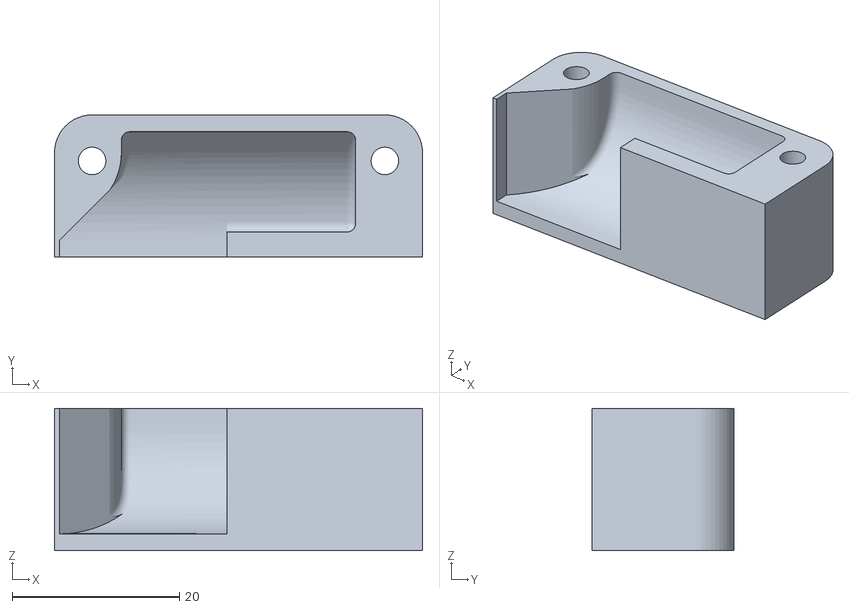
[picture p30: CAD file, 2024-07-03]
STLs/Toolhead/Toolhead_5015_Duct.stl
44.0 x 17.0 x 17.0
