R3pRapst3r/Trinity/STLs/Z System/Z A-Carrier_1x.stl

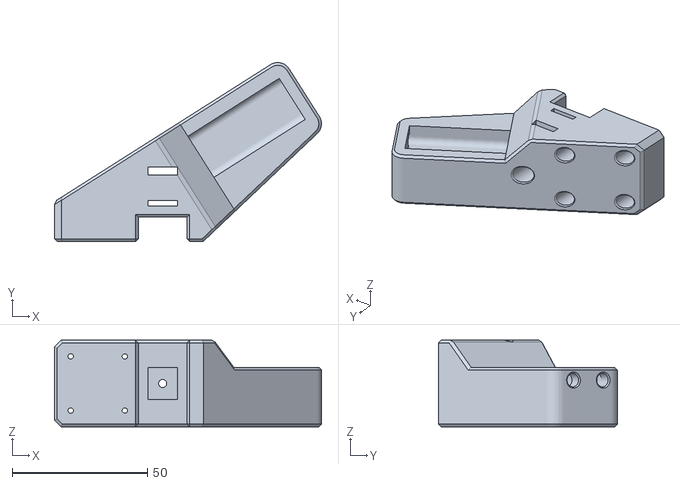
[picture p31: CAD file, 2024-06-25]
STLs/Z System/Z A-Carrier_1x.stl
98.7 x 66.2 x 32.0
