R3pRapst3r/Trinity/STLs/AB System/AB Motor Bracket_1x.stl

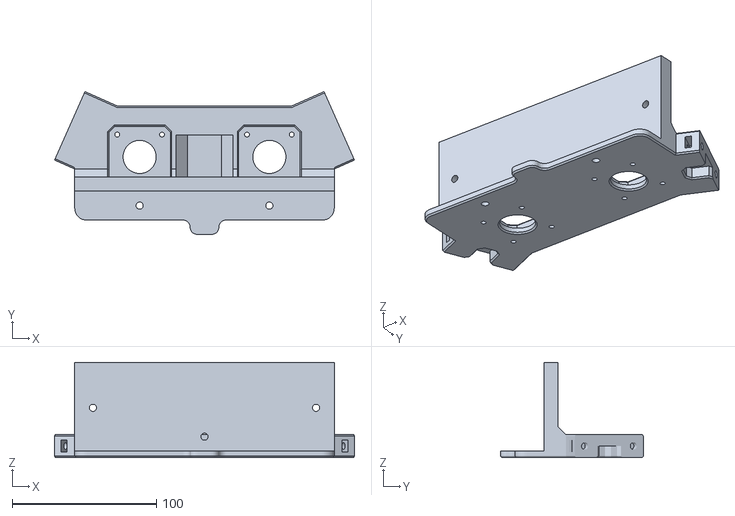
[picture p32: CAD file, 2024-06-25]
STLs/AB System/AB Motor Bracket_1x.stl
208.1 x 99.1 x 66.0
