R3pRapst3r/Trinity/STLs/Enclosure/ULA-AB Lower Elbow_4x.stl

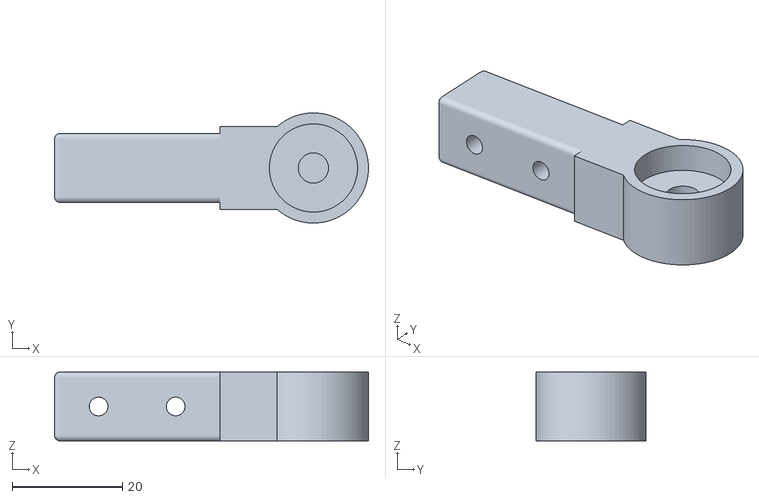
[picture p33: CAD file, 2024-06-25]
STLs/Enclosure/ULA-AB Lower Elbow_4x.stl
57.0 x 20.0 x 12.5
