R3pRapst3r/Trinity/STLs/Toolhead/Toolhead_TopPlate_DragonUHF.stl

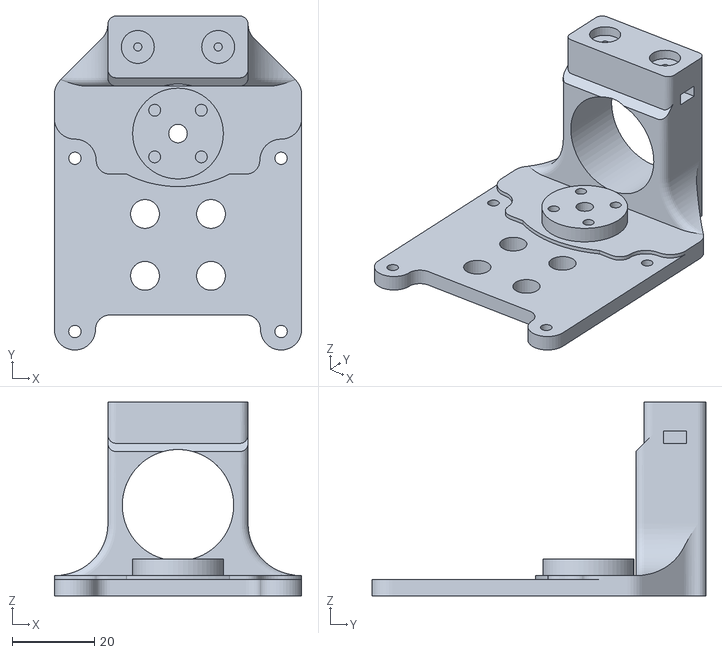
[picture p34: CAD file, 2024-07-03]
STLs/Toolhead/Toolhead_TopPlate_DragonUHF.stl
60.0 x 81.0 x 47.0
