R3pRapst3r/Trinity/STLs/Z System/Z C-Coverbuddy_1x.stl

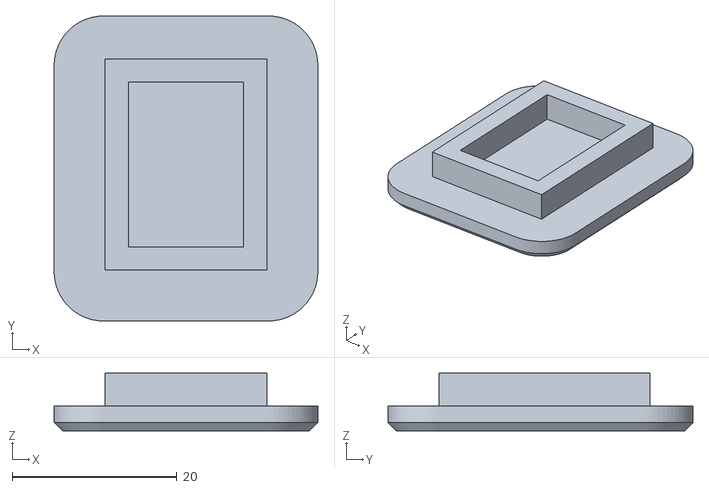
[picture p35: CAD file, 2024-06-25]
STLs/Z System/Z C-Coverbuddy_1x.stl
32.0 x 37.0 x 7.00
