R3pRapst3r/Trinity/STLs/AB System/A Y-Carrier A2_1x.stl

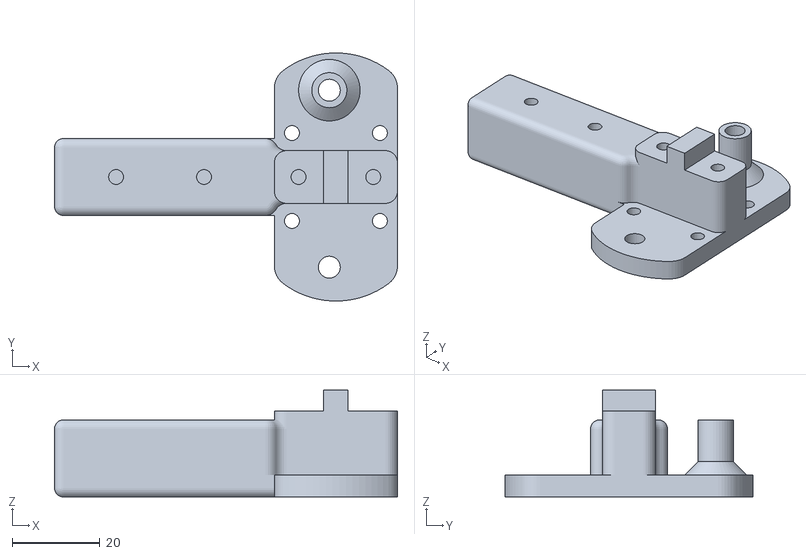
[picture p36: CAD file, 2024-06-25]
STLs/AB System/A Y-Carrier A2_1x.stl
78.0 x 56.4 x 24.3
