R3pRapst3r/Trinity/STLs/Toolhead/Toolhead_PCF_Mount.stl

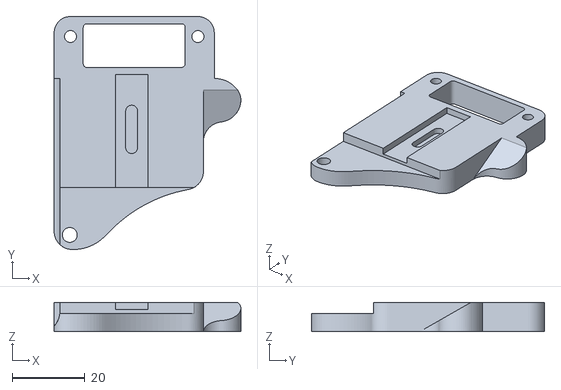
[picture p37: CAD file, 2024-07-03]
STLs/Toolhead/Toolhead_PCF_Mount.stl
51.3 x 64.0 x 8.00
