R3pRapst3r/Trinity/STLs/Z System/Z AB-Belt Lock_2x.stl

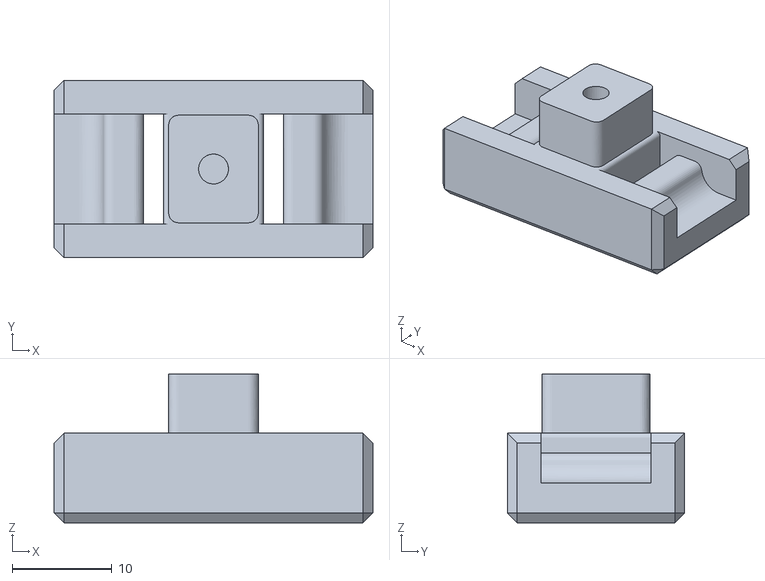
[picture p38: CAD file, 2024-06-25]
STLs/Z System/Z AB-Belt Lock_2x.stl
32.0 x 17.8 x 14.9
