R3pRapst3r/Trinity/STLs/AB System/AB Idler Spacer_4x.stl

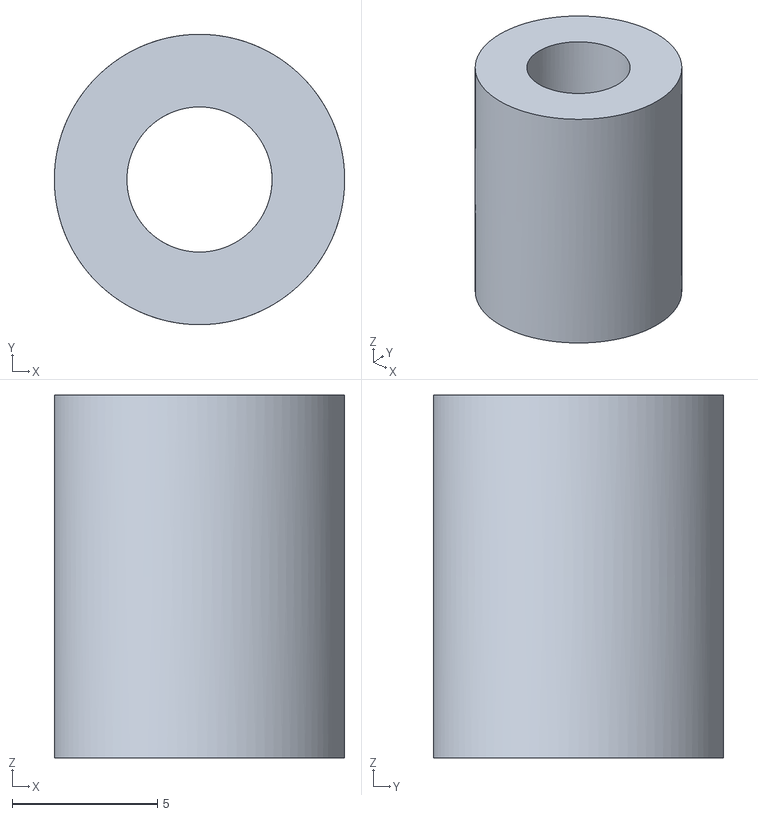
[picture p39: CAD file, 2024-06-25]
STLs/AB System/AB Idler Spacer_4x.stl
10.0 x 10.00 x 12.5
