R3pRapst3r/Trinity/STLs/Enclosure/Doorlift Upper Arm Bracket A_1x.stl

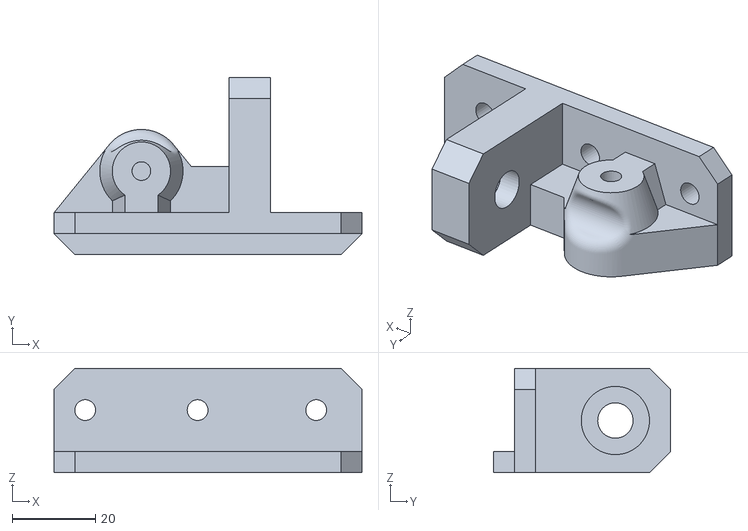
[picture p40: CAD file, 2024-06-25]
STLs/Enclosure/Doorlift Upper Arm Bracket A_1x.stl
74.0 x 42.5 x 25.0
