R3pRapst3r/Trinity/STLs/Toolhead/Toolhead_BedProbe.stl

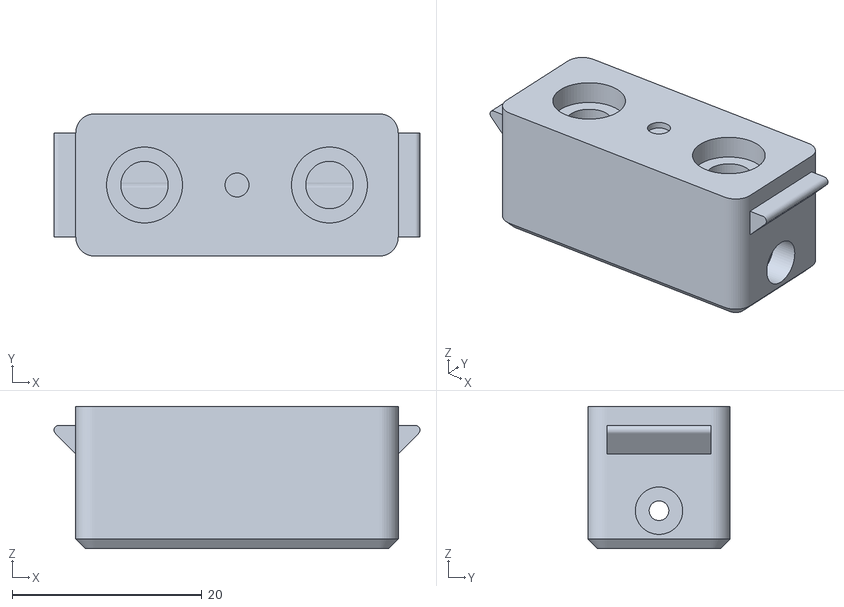
[picture p41: CAD file, 2024-07-03]
STLs/Toolhead/Toolhead_BedProbe.stl
38.6 x 15.0 x 15.0
