R3pRapst3r/Trinity/STLs/Enclosure/Door Handle A_1x.stl

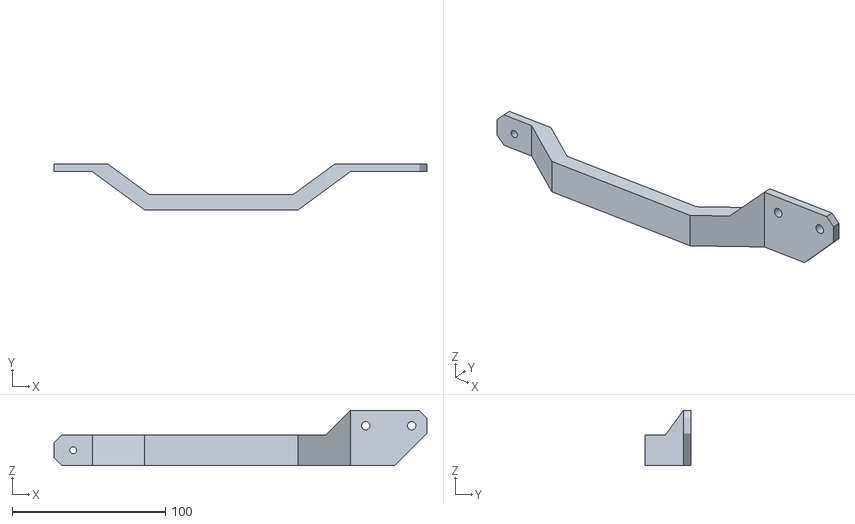
[picture p42: CAD file, 2024-06-25]
STLs/Enclosure/Door Handle A_1x.stl
243.2 x 30.0 x 36.0
