R3pRapst3r/Trinity/STLs/Toolhead/Toolhead_ExtruderMount_L.stl

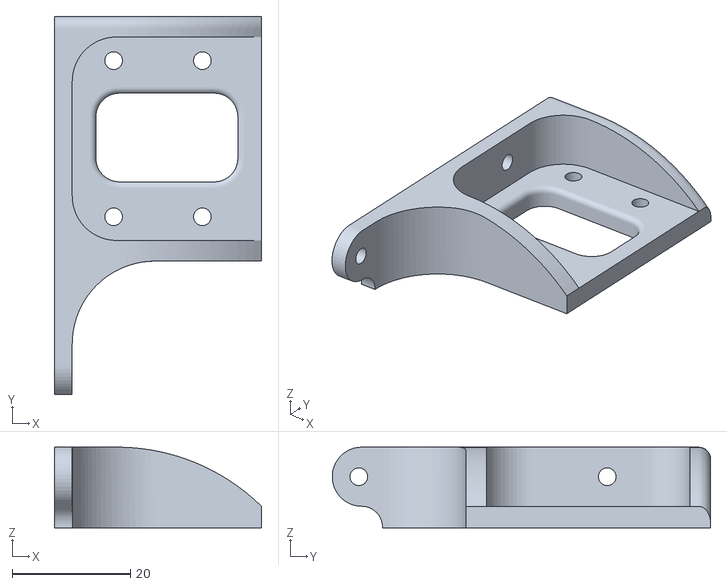
[picture p43: CAD file, 2024-07-03]
STLs/Toolhead/Toolhead_ExtruderMount_L.stl
35.0 x 64.0 x 13.6
