R3pRapst3r/Trinity/STLs/Z System/Z AB-Coverbuddy_2x.stl

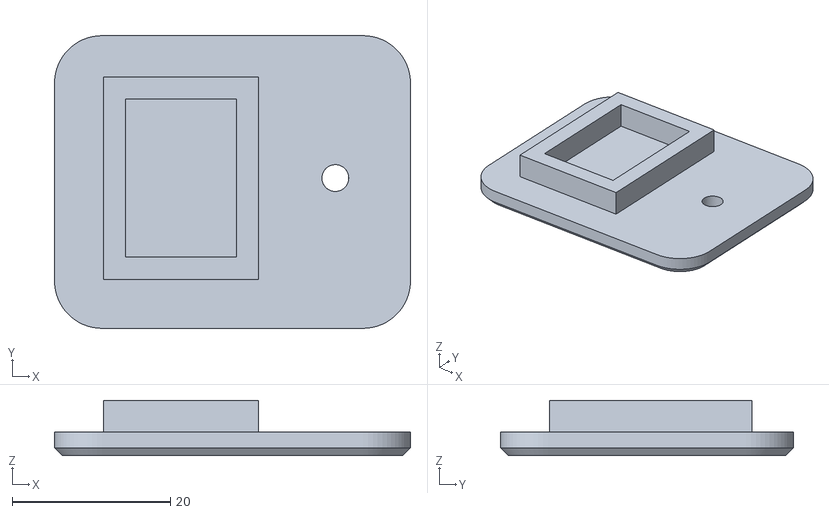
[picture p44: CAD file, 2024-06-25]
STLs/Z System/Z AB-Coverbuddy_2x.stl
45.0 x 37.0 x 7.00
