R3pRapst3r/Trinity/STLs/AB System/A Y-Carrier A1_1x.stl

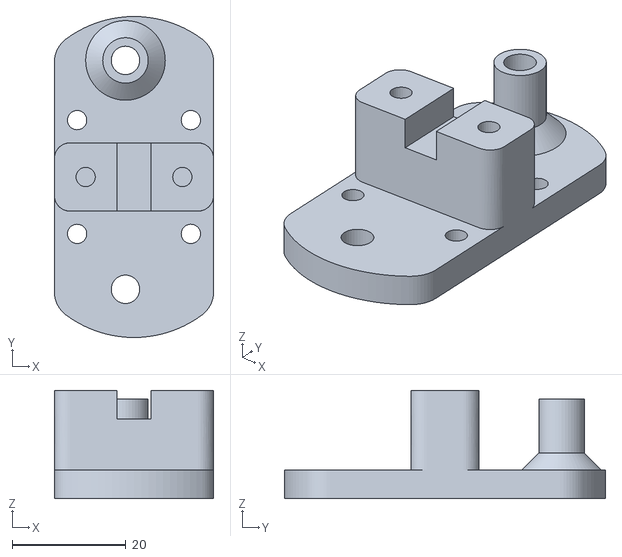
[picture p45: CAD file, 2024-06-25]
STLs/AB System/A Y-Carrier A1_1x.stl
28.0 x 56.4 x 19.0
