R3pRapst3r/Trinity/STLs/Enclosure/Door Window Frame Inner_2x.stl

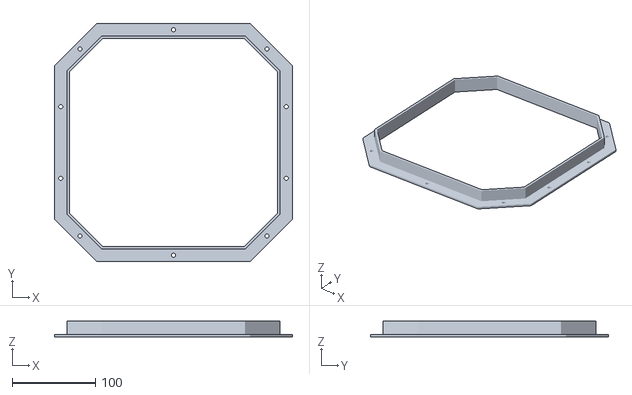
[picture p46: CAD file, 2024-06-25]
STLs/Enclosure/Door Window Frame Inner_2x.stl
286.0 x 286.0 x 19.0
