R3pRapst3r/Trinity/STLs/Z System/Z C-Carrier_1x.stl

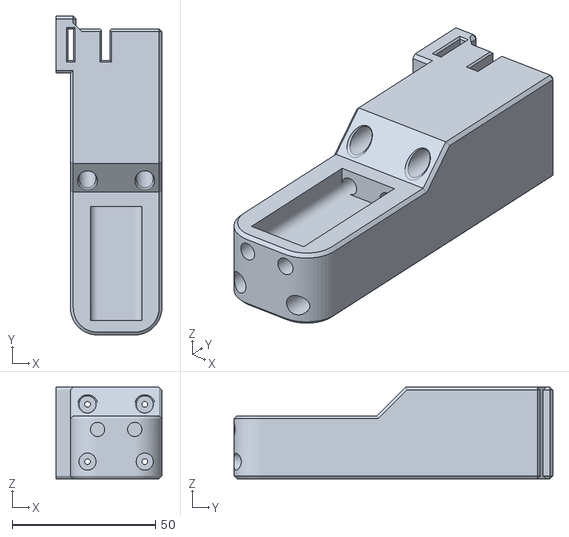
[picture p47: CAD file, 2024-06-25]
STLs/Z System/Z C-Carrier_1x.stl
37.0 x 111.5 x 32.0
