R3pRapst3r/Trinity/STLs/Enclosure/AB Rear Motor Cover_1x.stl

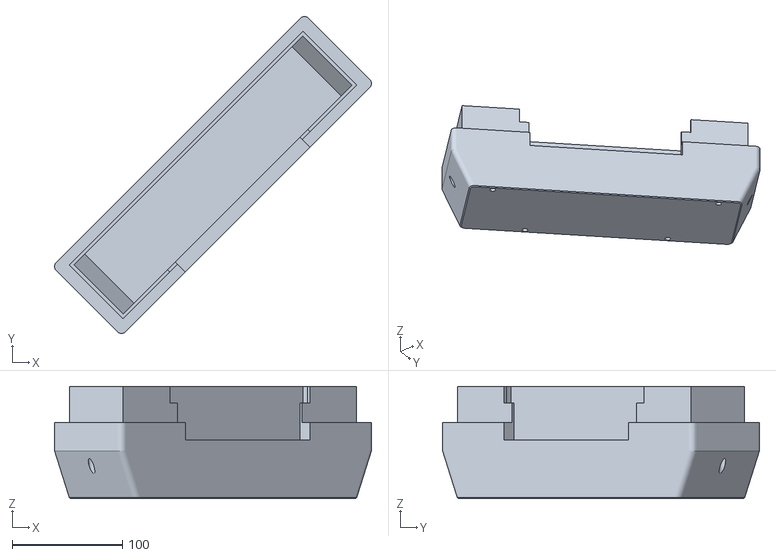
[picture p48: CAD file, 2024-06-25]
STLs/Enclosure/AB Rear Motor Cover_1x.stl
287.9 x 287.9 x 102.0
