R3pRapst3r/Trinity/STLs/AB System/B Idler Tension Tower_1x.stl

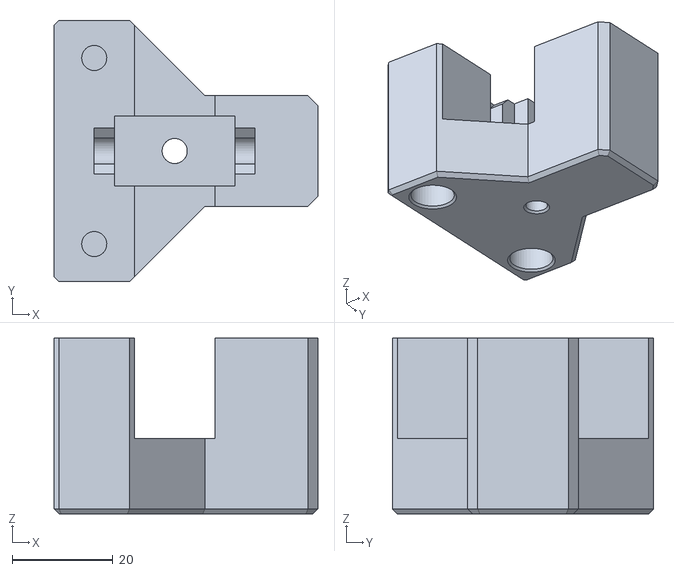
[picture p49: CAD file, 2024-06-25]
STLs/AB System/B Idler Tension Tower_1x.stl
52.5 x 52.0 x 35.0
