R3pRapst3r/Trinity/STLs/Enclosure/window cut template.stl

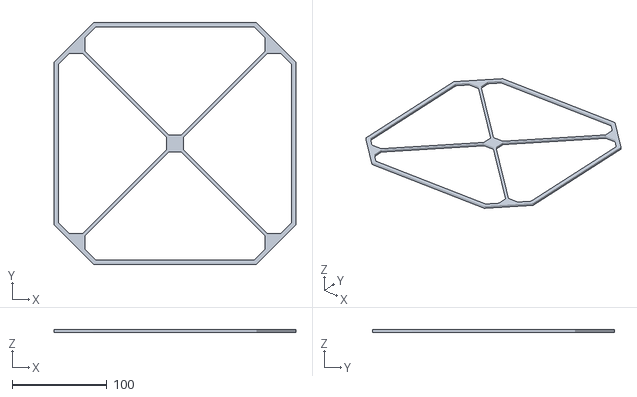
[picture p50: CAD file, 2024-06-25]
STLs/Enclosure/window cut template.stl
256.0 x 256.0 x 3.00
