R3pRapst3r/Trinity/STLs/Z System/Z Idler Bracket C_1x.stl

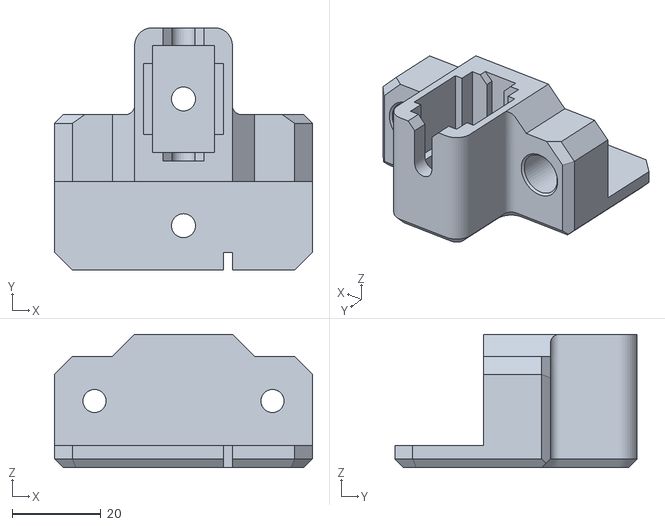
[picture p51: CAD file, 2024-06-25]
STLs/Z System/Z Idler Bracket C_1x.stl
58.0 x 54.5 x 30.0
