R3pRapst3r/Trinity/STLs/Enclosure/Doorlift Lower Arm Bracket AB_2x.stl

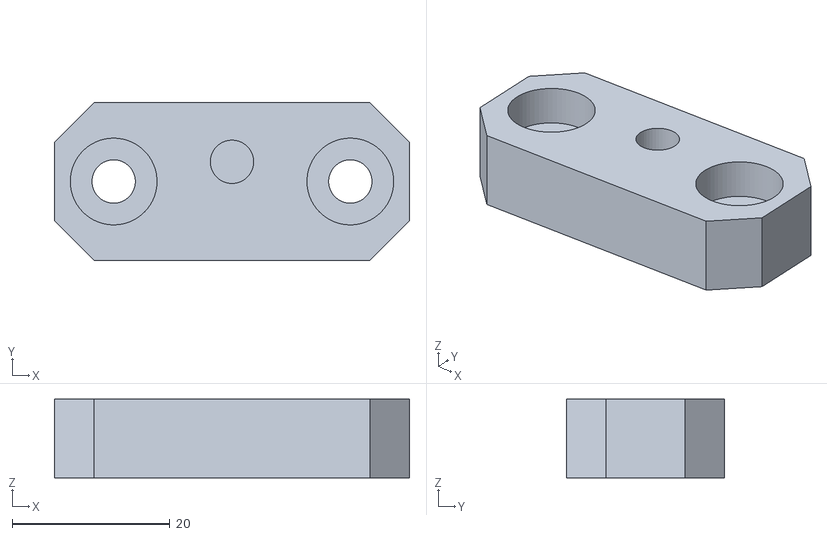
[picture p52: CAD file, 2024-06-25]
STLs/Enclosure/Doorlift Lower Arm Bracket AB_2x.stl
45.0 x 20.0 x 10.00
