R3pRapst3r/Trinity/STLs/Z System/Z C-Belt Lock_1x.stl

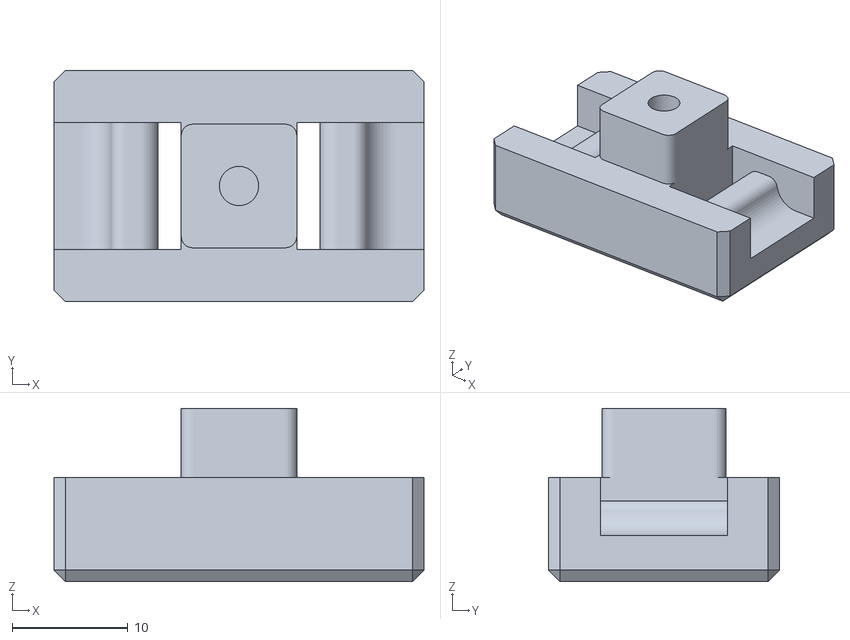
[picture p53: CAD file, 2024-06-25]
STLs/Z System/Z C-Belt Lock_1x.stl
32.0 x 20.0 x 15.0
