R3pRapst3r/Trinity/STLs/Z System/ZCB-Gear Bracket_1x.stl

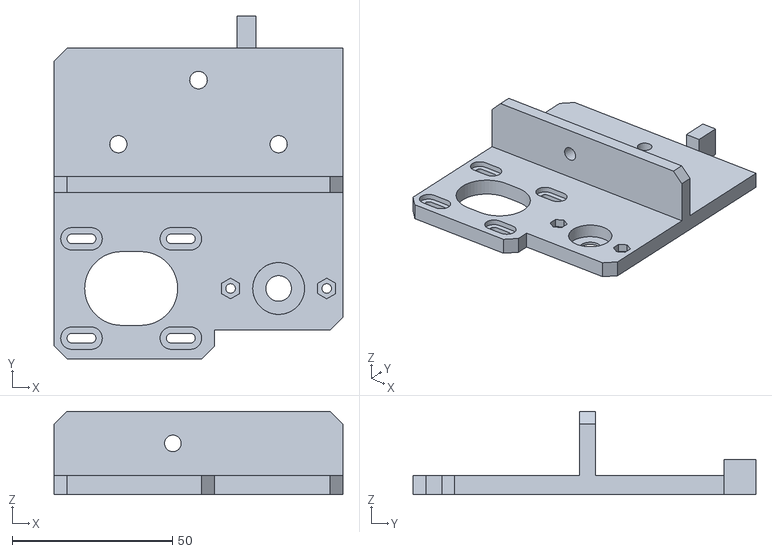
[picture p54: CAD file, 2024-06-25]
STLs/Z System/ZCB-Gear Bracket_1x.stl
90.0 x 107.0 x 26.0
