R3pRapst3r/Trinity/STLs/Z System/Z Idler Bracket AB_2x.stl

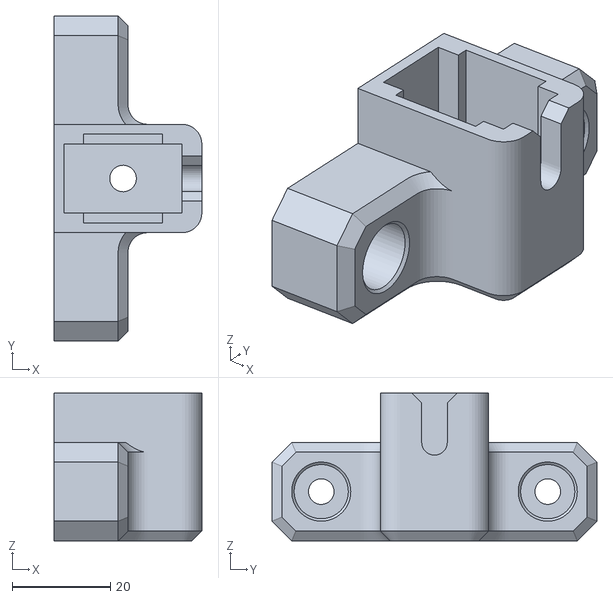
[picture p55: CAD file, 2024-06-25]
STLs/Z System/Z Idler Bracket AB_2x.stl
30.0 x 66.0 x 30.0
