R3pRapst3r/Trinity/STLs/Enclosure/LA-AB Upper Elbow_2x.stl

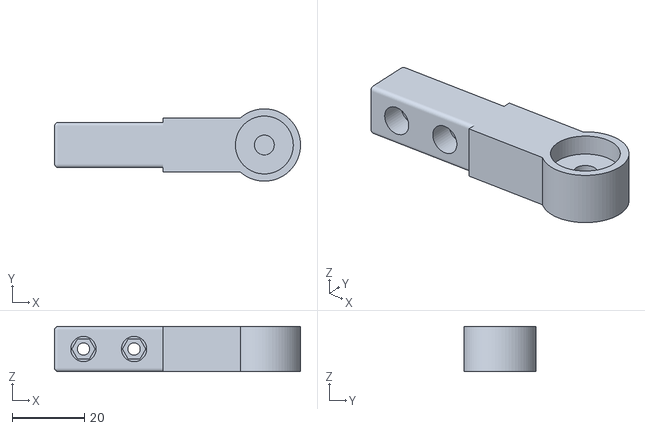
[picture p56: CAD file, 2024-06-25]
STLs/Enclosure/LA-AB Upper Elbow_2x.stl
68.0 x 20.0 x 12.5
