R3pRapst3r/Trinity/STLs/Enclosure/Door Window Frame Outer_1x.stl

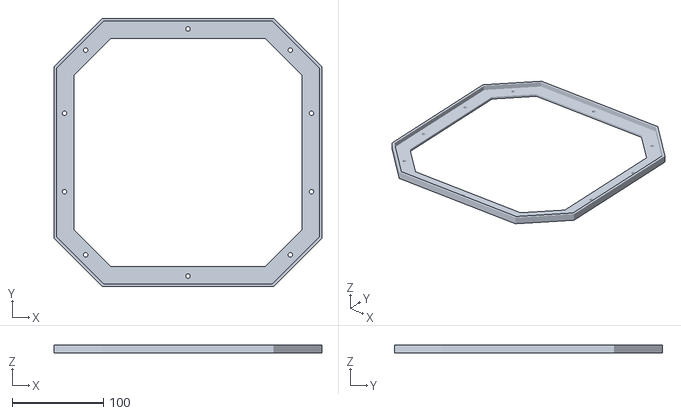
[picture p57: CAD file, 2024-06-25]
STLs/Enclosure/Door Window Frame Outer_1x.stl
294.0 x 294.0 x 9.00
