R3pRapst3r/Trinity/STLs/Z System/Z ABC Tension Fork_3x.stl

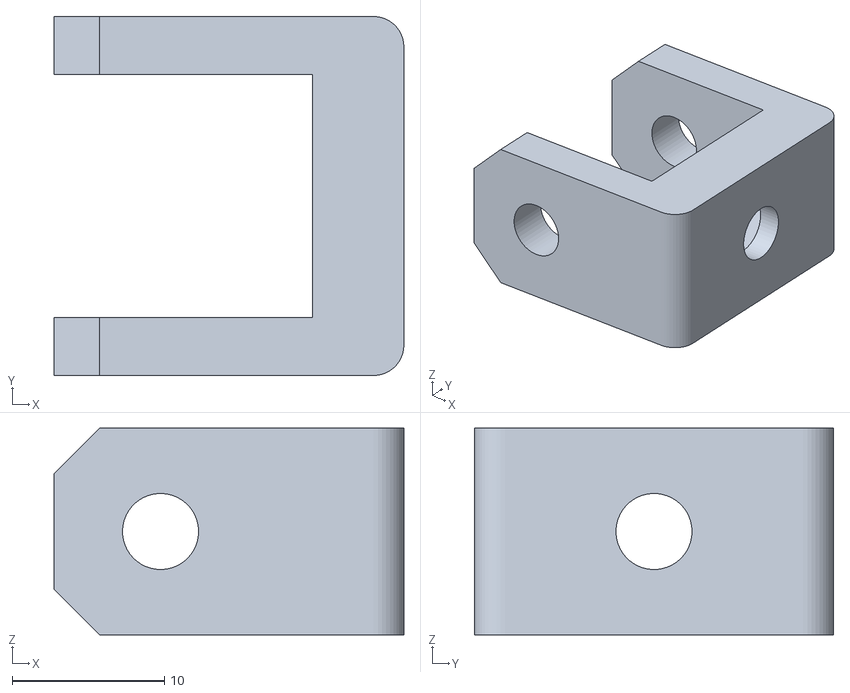
[picture p58: CAD file, 2024-06-25]
STLs/Z System/Z ABC Tension Fork_3x.stl
23.0 x 23.6 x 13.6
