R3pRapst3r/Trinity/STLs/Enclosure/Motherboard backpack cover_1x.stl

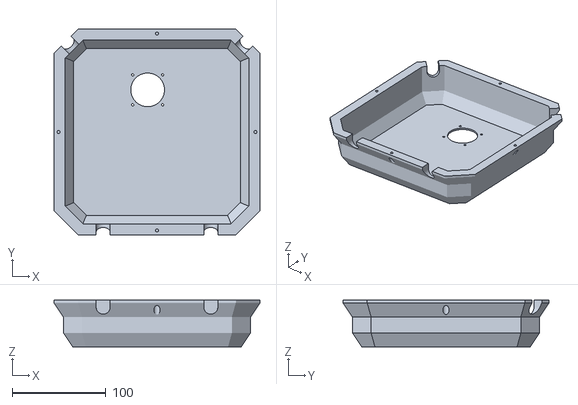
[picture p59: CAD file, 2024-06-25]
STLs/Enclosure/Motherboard backpack cover_1x.stl
220.0 x 220.0 x 50.0
