R3pRapst3r/Trinity/(list of files, cad)

Other CAD files:
STLs/AB System/B Idler Bracket Front_1x.stl
STLs/Enclosure/Doorlift Door Bracket A_1x.stl
STLs/Z System/Z B-Gear Bracket_1x.stl
STLs/AB System/B Y-Carrier B2_1x.stl
STLs/AB System/A Idler Bracket Rear_1x.stl
STLs/Z System/Z B-Carrier_1x.stl
STLs/AB System/B Y-Carrier B1_1x.stl
STLs/Enclosure/UA-B Upper Elbow_1x.stl
STLs/Z System/Z A-Gear Cover_1x.stl
STLs/Enclosure/Doorlift Upper Arm Bracket B_1x.stl
STLs/Enclosure/Door Handle B_1x.stl
STLs/Frame Leg Thumb Screw_4x.stl
