R3pRapst3r/Trinity/CAD/Images/355mm_build_plate.png

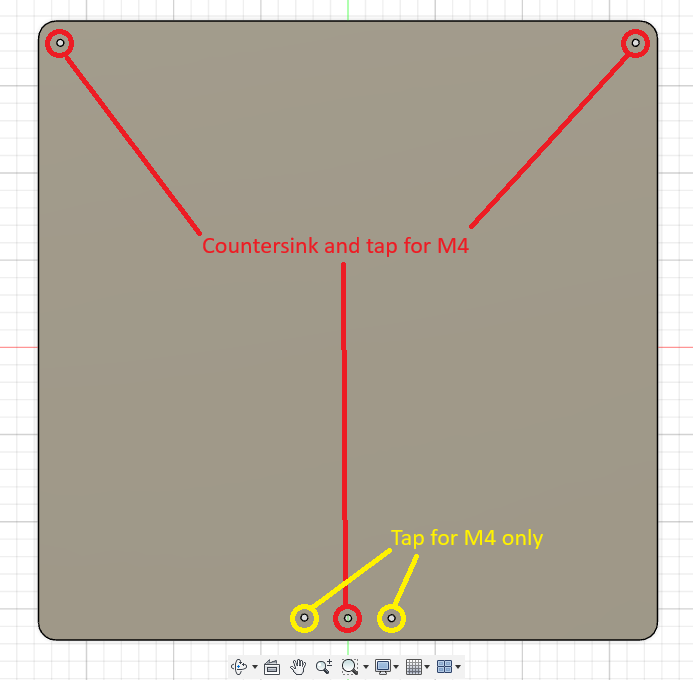
CAD/Images/355mm_build_plate.png
