R3pRapst3r/Trinity/CAD/Buildplate Drawing.pdf

2

3

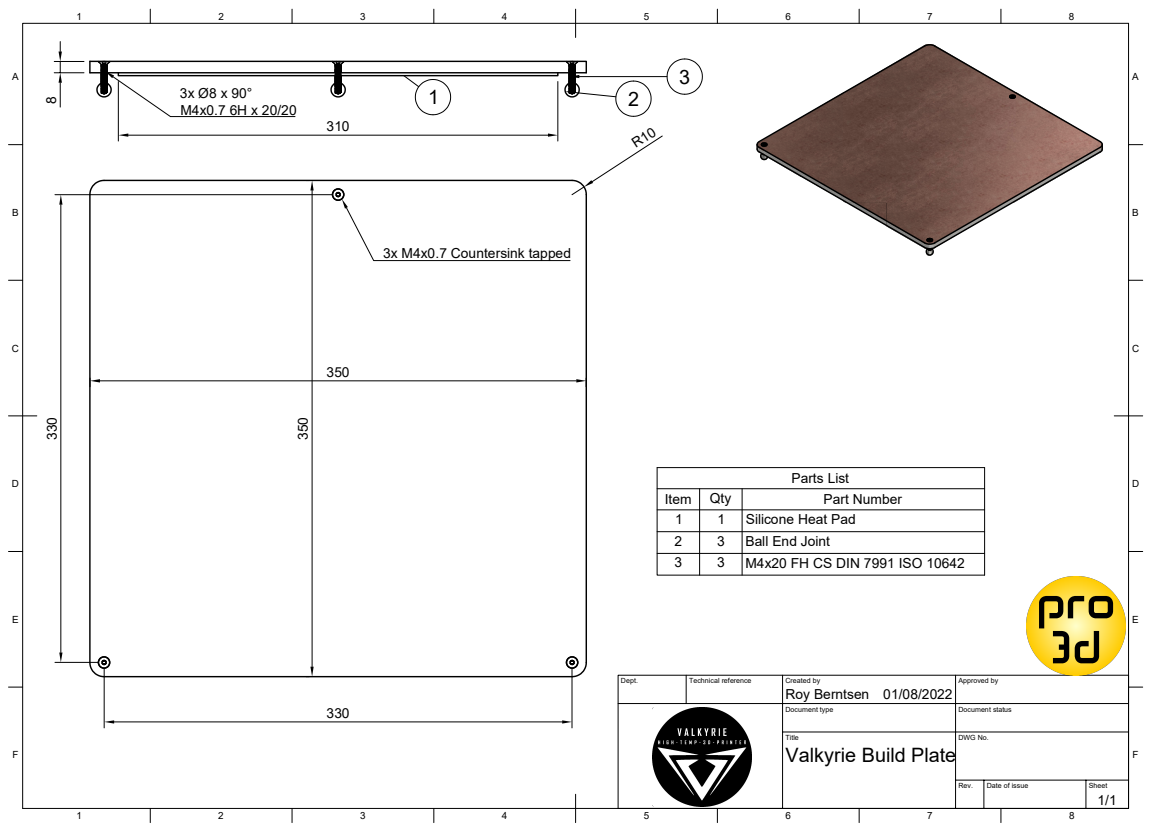
[picture p61: page 1]
Dept.; Technical reference; Created by; Approved by; Document type; Document status; Title; DWG No.; Rev.; Date of issue; Sheet; 330 ³³⁰; Parts List; Item; Qty; Part Number; Silicone Heat Pad; Ball End Joint; M4x20 FH CS DIN 7991 ISO 10642; 3x M4x0.7 Countersink tapped

Roy Berntsen ³⁵⁰

Valkyrie Build Plate
