R3pRapst3r/Trinity/(commit log)

2024-06-25 initial resize to 320^3
    [350mm_build_plate.dxf, A Idler Bracket Front_1x.stl, A Idler Bracket Rear_1x.stl, A Idler Tension Tower_1x.stl, A Y-Carrier A1_1x.stl, A Y-Carrier A2_1x.stl, AB Idler Spacer_4x.stl, AB Motor Bracket_1x.stl]
2024-06-26 toolhead plate fix
    [Toolhead Top Plate_1x.stl]
2024-06-29 toolhead w/uHF hotend
2024-06-29 compressed step files
    [Filament_ROS.f3z, Toolhead Top Plate (NF Smart).step]
2024-06-29 add BOM differences to README
2024-06-29 remove frame drawing
    [PTC Heater Mount.step]
2024-07-01 dragon UHF toolhead
2024-07-02 MR buildplate
    [355mm_build_plate.step]
2024-07-03 EVA 2.4 UHF tri-horn fan duct
    [5015_Fan_Duct.stl, 5015_Mount_Plate.stl, 5015_Mount_Plate_Spacer.stl]
2024-07-03 toolhead STLs
    [Toolhead_BedProbe.stl, Toolhead_ExtruderMount_L.stl, Toolhead_ExtruderMount_R.stl]
2024-07-03 purge optional STLs
    [Purge Bucket.stl, ROS Housing.stl, ROS Lid.stl, ROS Throughput Nut.stl, ROS Throughput Washer.stl, ROS Throughput.stl, V Slot Cable Cover_10x_SN_BN.stl]
2024-07-05 EBB STL / Bed STEP
    [355mm_build_plate.step, Toolhead_Carrier.stl, Toolhead_ExtruderEBB_Mount.stl, Toolhead_ExtruderMount_R.stl]
2024-07-25 door and motor cover
    [DIN_Rail_Mount_4x.stl]
